NathanFSavoie/KiCad_lib/3D_Model/Assembly/mps_dcdc_oki_78sr_vert_a.step

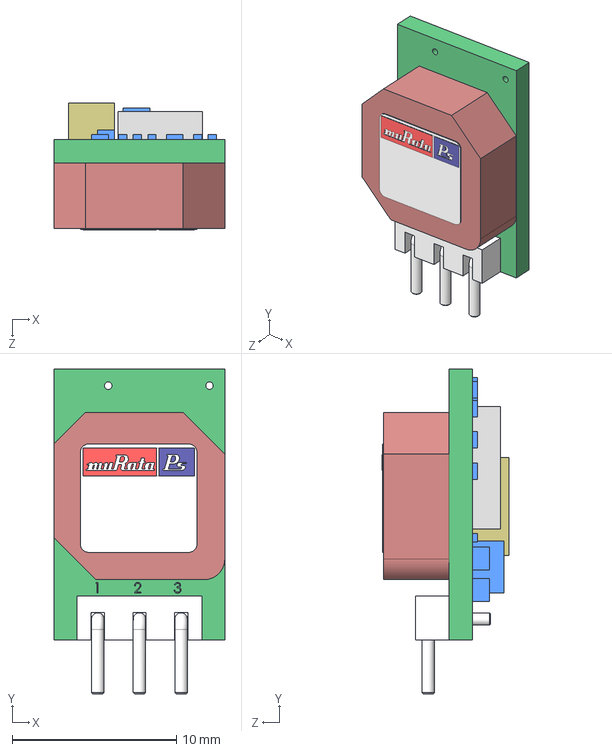
[picture p1: CAD file, 2017-04-19]
3D_Model/Assembly/mps_dcdc_oki_78sr_vert_a.step
10.4 x 19.8 x 7.73 mm
