NathanFSavoie/KiCad_lib/3D_Model/Capacitors/CAP_ALU_SMD_SIZE_D.step

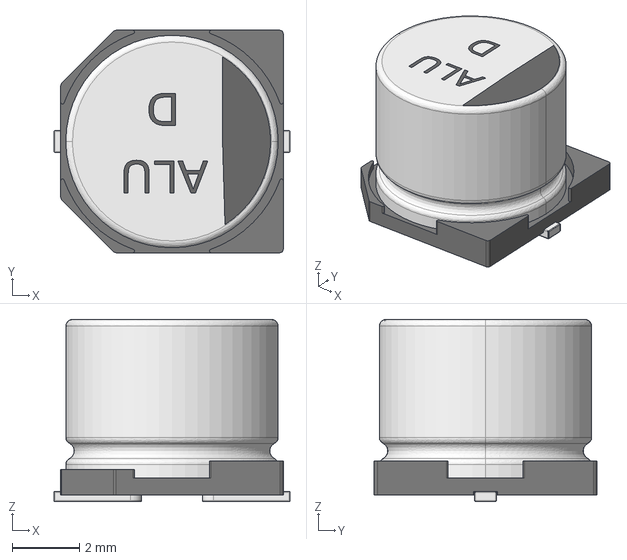
[picture p2: CAD file, 2017-10-21]
3D_Model/Capacitors/CAP_ALU_SMD_SIZE_D.step
7.00 x 6.60 x 5.40 mm
