NathanFSavoie/KiCad_lib/3D_Model/Connectors/PJ-202A.step

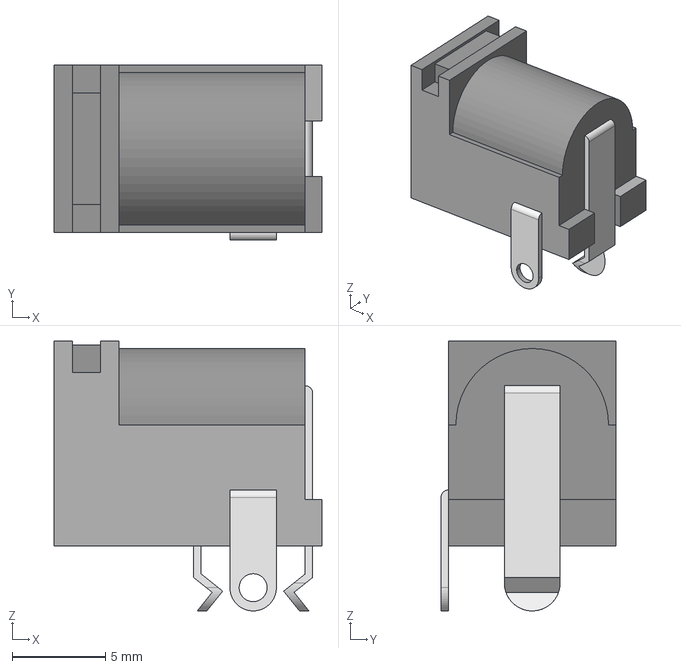
[picture p3: CAD file, 2017-10-21]
3D_Model/Connectors/PJ-202A.step
14.4 x 9.40 x 14.5 mm
