NathanFSavoie/KiCad_lib/3D_Model/Crystals/Crystal HC49_US-SM.step

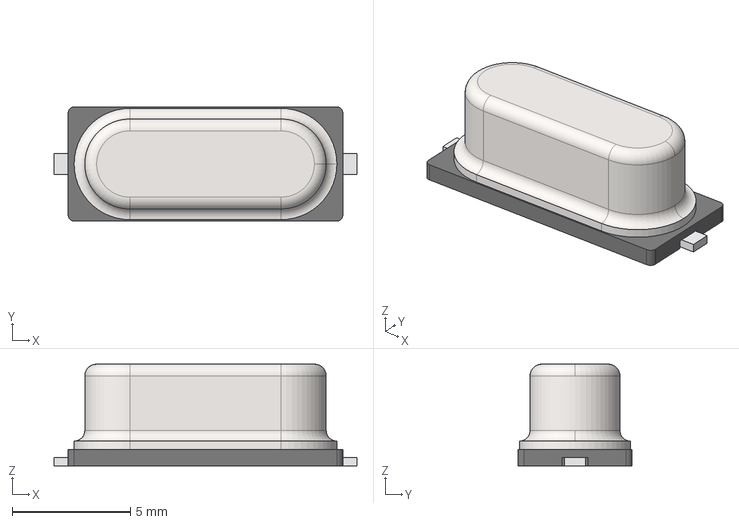
[picture p4: CAD file, 2017-10-21]
3D_Model/Crystals/Crystal HC49_US-SM.step
12.8 x 4.83 x 4.30 mm
