NathanFSavoie/KiCad_lib/3D_Model/Diodes/SOD-123.step

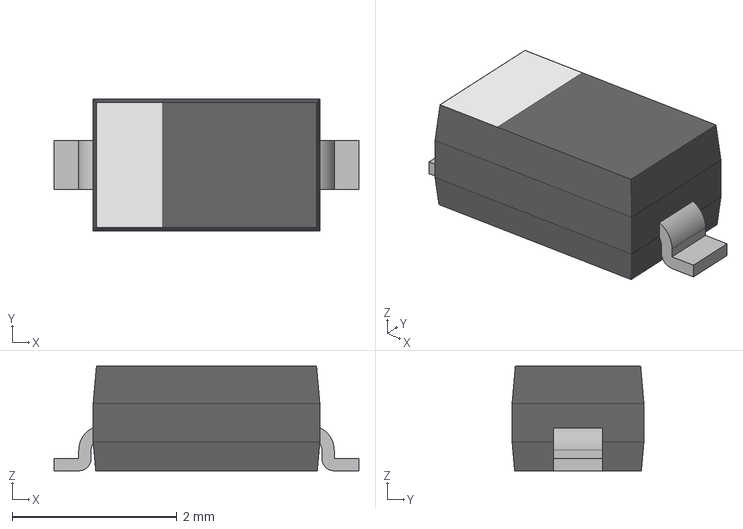
[picture p5: CAD file, 2017-11-20]
3D_Model/Diodes/SOD-123.step
3.70 x 1.60 x 1.27 mm
