NathanFSavoie/KiCad_lib/3D_Model/Fuses/F1206.step

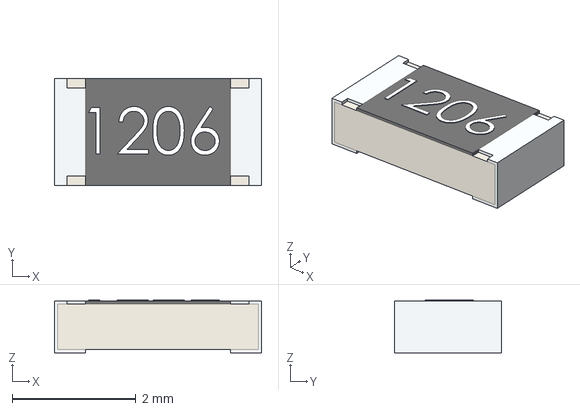
[picture p6: CAD file, 2017-10-21]
3D_Model/Fuses/F1206.step
3.35 x 1.73 x 0.85 mm
