NathanFSavoie/KiCad_lib/3D_Model/IC/SOIC-18.STEP

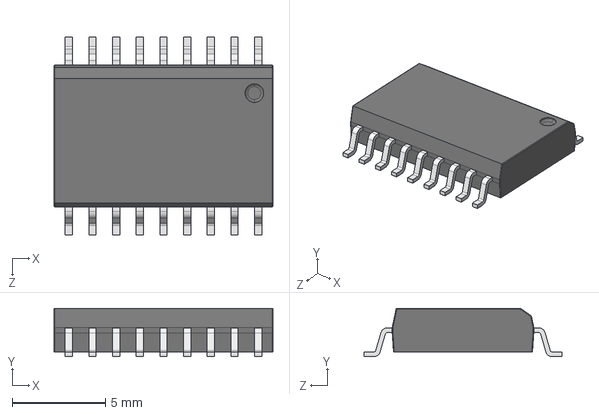
[picture p7: CAD file, 2017-10-21]
3D_Model/IC/SOIC-18.STEP
11.8 x 2.60 x 10.6 mm
User Library-SOIC-18-300_pin_SOIC_SO-300_1 x 18
User Library-SOIC-18-300_SOIC_300_SOIC_11.75X7.6_1
