NathanFSavoie/KiCad_lib/3D_Model/Inductors/LBC3225.stp

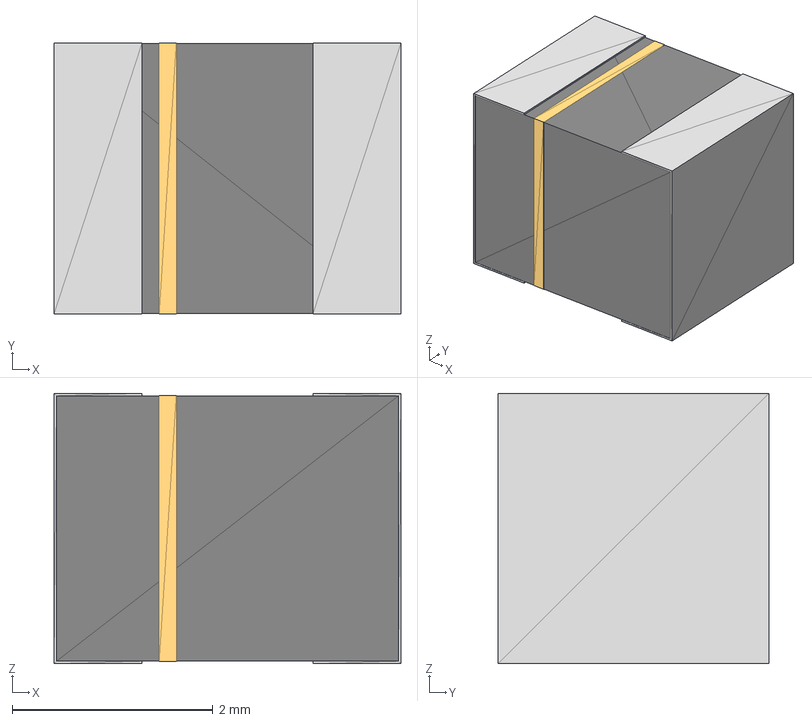
[picture p8: CAD file, 2017-05-11]
3D_Model/Inductors/LBC3225.stp
3.45 x 2.70 x 2.69 mm
