NathanFSavoie/KiCad_lib/3D_Model/Miscellaneous/MIC_CMA.step

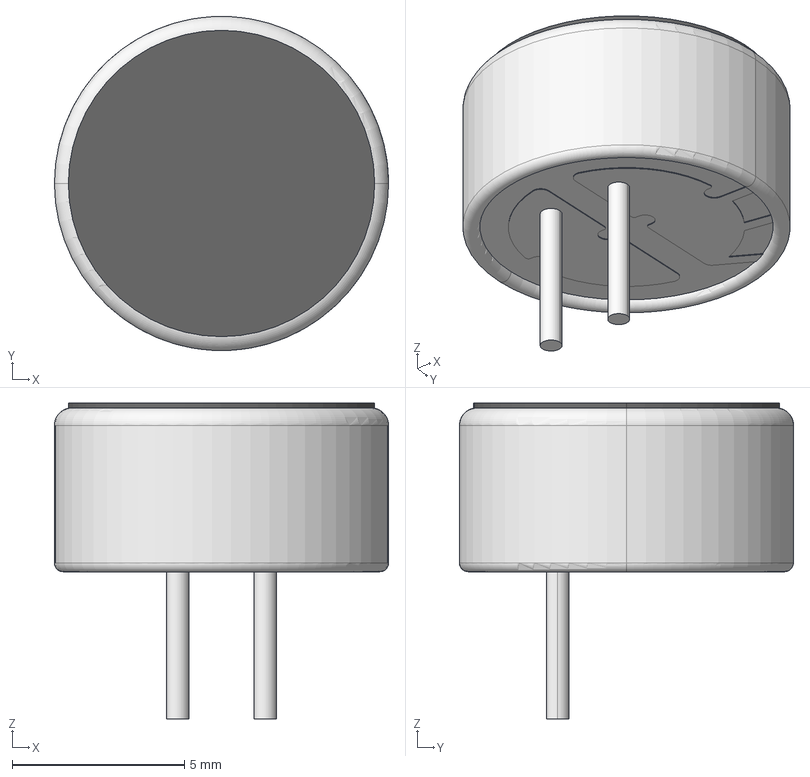
[picture p9: CAD file, 2017-10-21]
3D_Model/Miscellaneous/MIC_CMA.step
9.70 x 9.69 x 9.17 mm
