NathanFSavoie/KiCad_lib/3D_Model/Switches/Tactile_switch_6x6x5mm.step

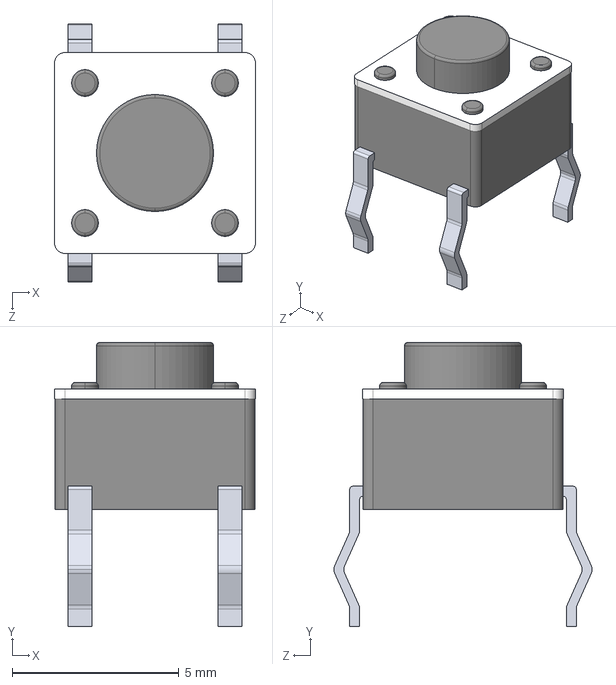
[picture p10: CAD file, 2017-01-31]
3D_Model/Switches/Tactile_switch_6x6x5mm.step
6.03 x 8.52 x 7.74 mm
