NathanFSavoie/KiCad_lib/3D_Model/Transistor/TO-220.stp

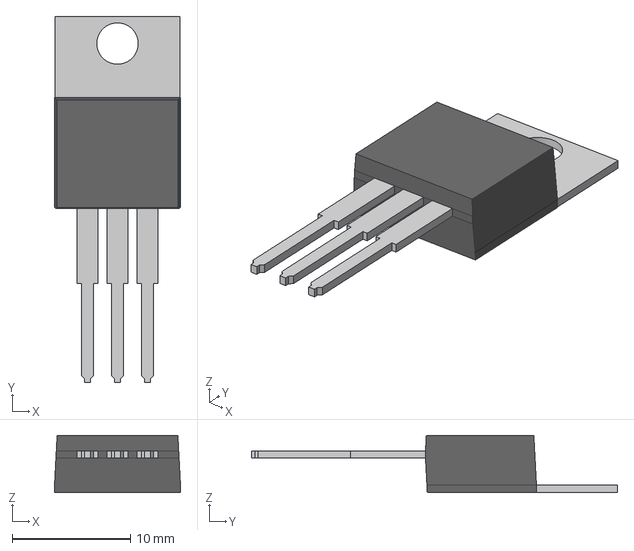
[picture p11: CAD file, 2017-10-21]
3D_Model/Transistor/TO-220.stp
10.7 x 31.0 x 4.83 mm
