NathanFSavoie/KiCad_lib/3D_Model/Assembly/mps_dcdc_oki_78sr_horiz_a.step

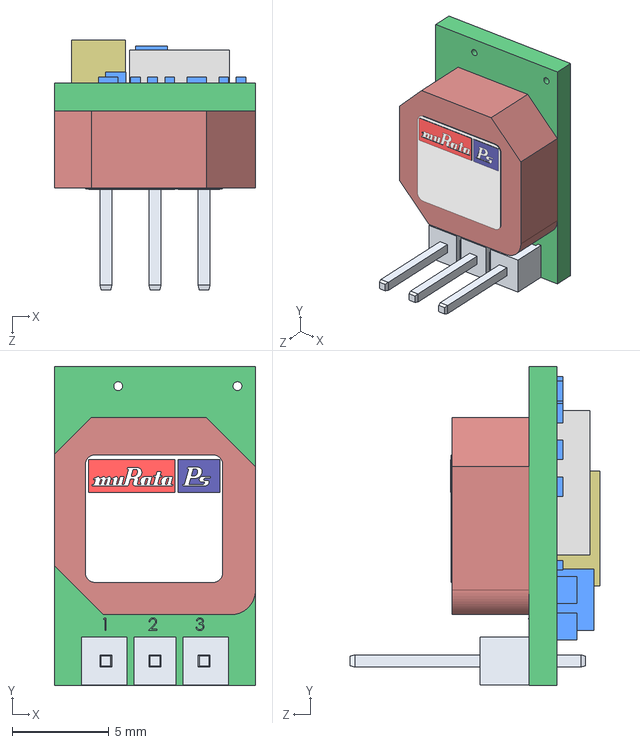
[picture p12: CAD file, 2017-04-19]
3D_Model/Assembly/mps_dcdc_oki_78sr_horiz_a.step
10.4 x 16.5 x 12.9 mm
