NathanFSavoie/KiCad_lib/3D_Model/Connectors/Male_Header_2_54mm_1X4.step

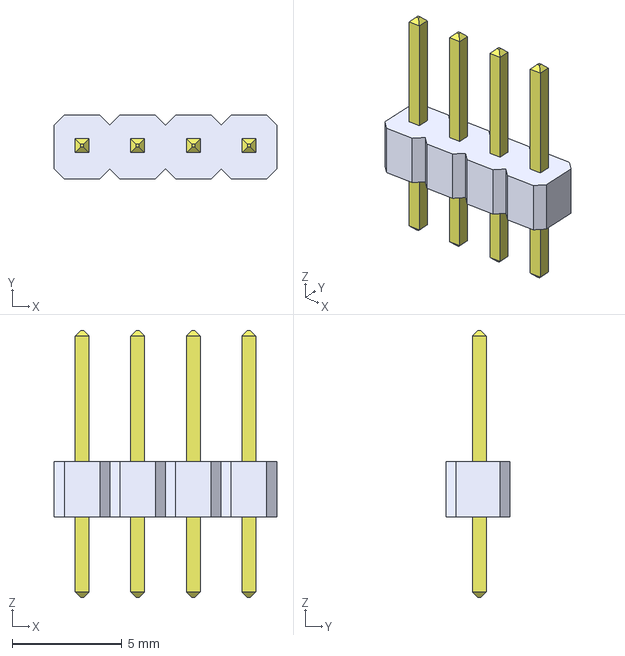
[picture p13: CAD file, 2017-10-21]
3D_Model/Connectors/Male_Header_2_54mm_1X4.step
10.2 x 2.92 x 12.2 mm
