NathanFSavoie/KiCad_lib/3D_Model/Crystals/ABS25.STEP

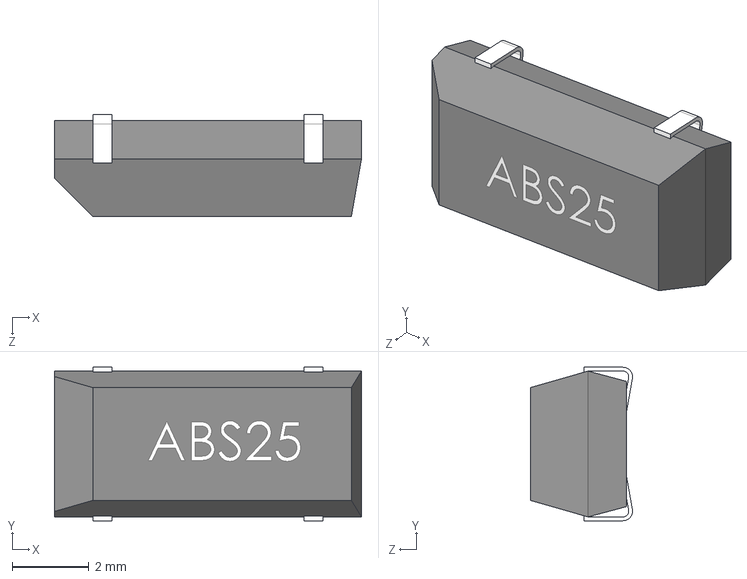
[picture p14: CAD file, 2017-04-19]
3D_Model/Crystals/ABS25.STEP
8.00 x 4.00 x 2.66 mm
