NathanFSavoie/KiCad_lib/3D_Model/Diodes/DO-201AD.step

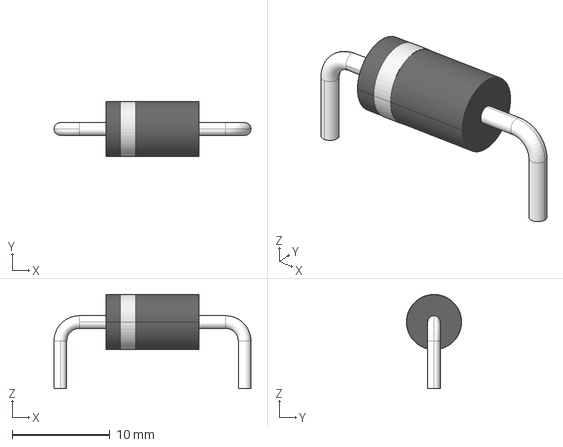
[picture p15: CAD file, 2017-10-21]
3D_Model/Diodes/DO-201AD.step
20.1 x 5.64 x 9.62 mm
