NathanFSavoie/KiCad_lib/3D_Model/Fuses/Littelfuse_562.stp

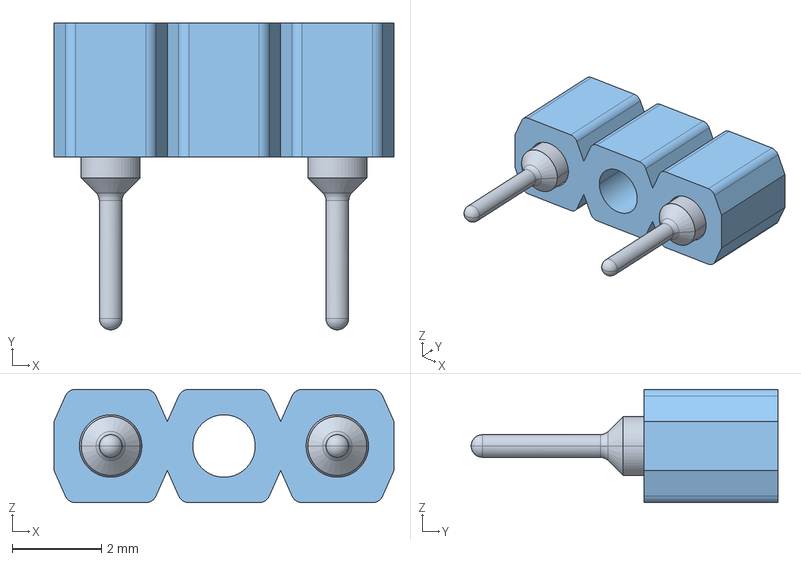
[picture p16: CAD file, 2017-04-29]
3D_Model/Fuses/Littelfuse_562.stp
7.62 x 6.88 x 2.54 mm
