NathanFSavoie/KiCad_lib/3D_Model/IC/SIP_4__Pitch_2_54mm.step

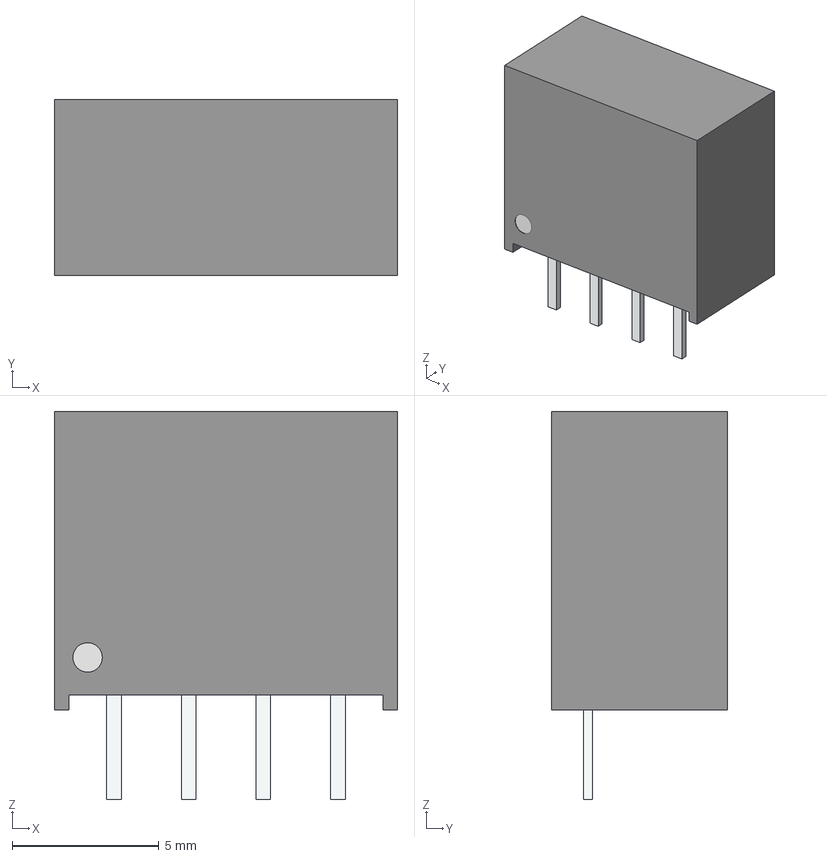
[picture p17: CAD file, 2017-10-21]
3D_Model/IC/SIP_4__Pitch_2_54mm.step
11.7 x 6.00 x 13.2 mm
