NathanFSavoie/KiCad_lib/3D_Model/Inductors/RLB0608.step

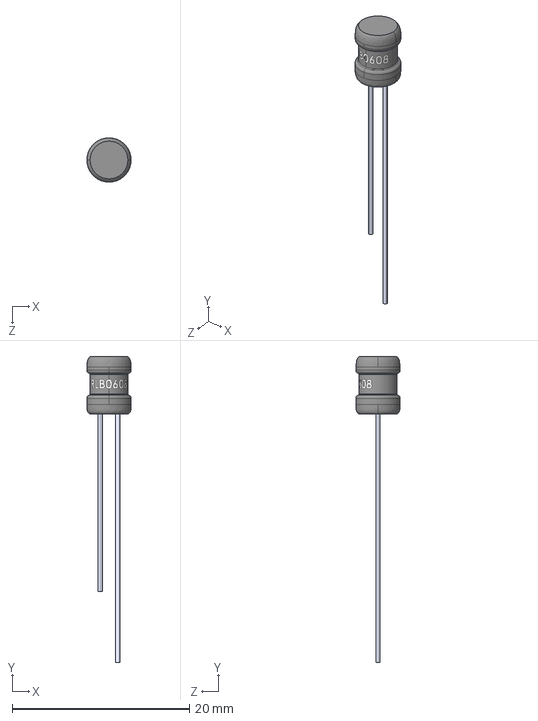
[picture p18: CAD file, 2017-05-09]
3D_Model/Inductors/RLB0608.step
5.00 x 34.5 x 5.00 mm
