NathanFSavoie/KiCad_lib/3D_Model/Resistors/Bourns 3362R_sp.step

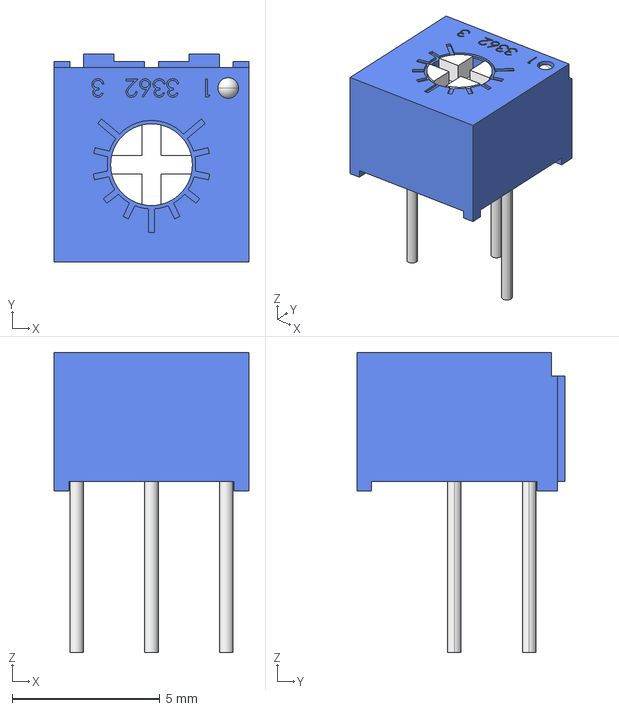
[picture p19: CAD file, 2017-10-21]
3D_Model/Resistors/Bourns 3362R_sp.step
6.60 x 7.05 x 10.2 mm
