NathanFSavoie/KiCad_lib/3D_Model/Capacitors/CAP_ALU_SMD_SIZE_B.step

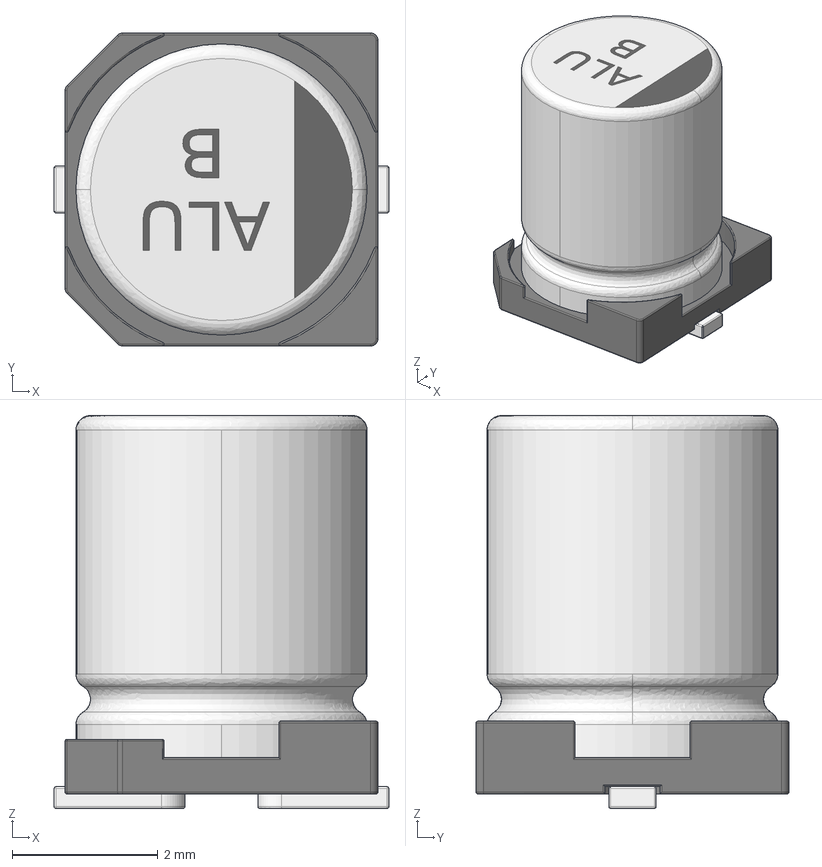
[picture p21: CAD file, 2017-10-21]
3D_Model/Capacitors/CAP_ALU_SMD_SIZE_B.step
4.60 x 4.30 x 5.40 mm
