NathanFSavoie/KiCad_lib/3D_Model/Connectors/Headers_2.54mm_1X9.step

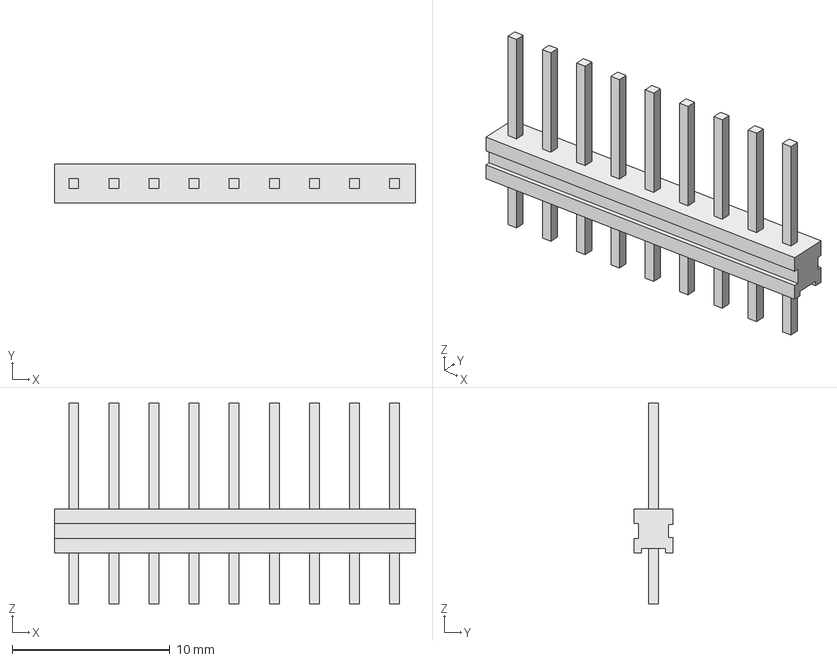
[picture p22: CAD file, 2017-10-21]
3D_Model/Connectors/Headers_2.54mm_1X9.step
22.9 x 2.50 x 12.7 mm
