NathanFSavoie/KiCad_lib/3D_Model/Diodes/LED 1206_GREEN.step

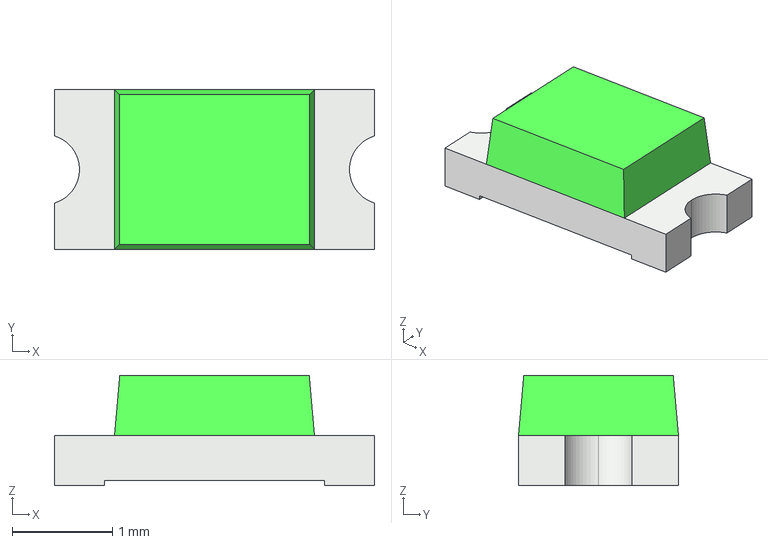
[picture p23: CAD file, 2017-10-21]
3D_Model/Diodes/LED 1206_GREEN.step
3.20 x 1.60 x 1.10 mm
