NathanFSavoie/KiCad_lib/3D_Model/Fuses/Littelfuse_TE5_395.step

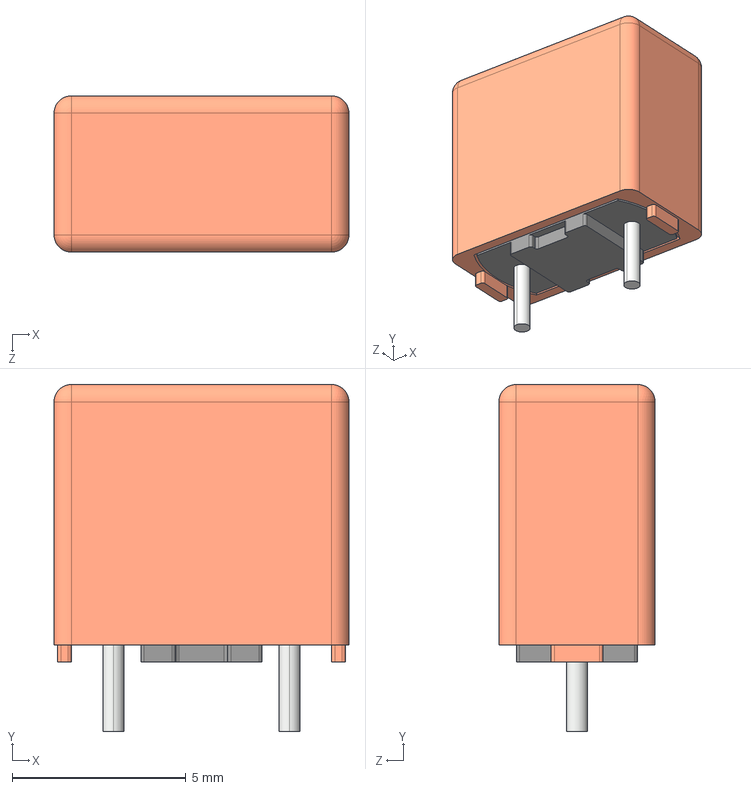
[picture p24: CAD file, 2017-04-29]
3D_Model/Fuses/Littelfuse_TE5_395.step
8.50 x 10.0 x 4.50 mm
