NathanFSavoie/KiCad_lib/3D_Model/IC/SOIC-8.step

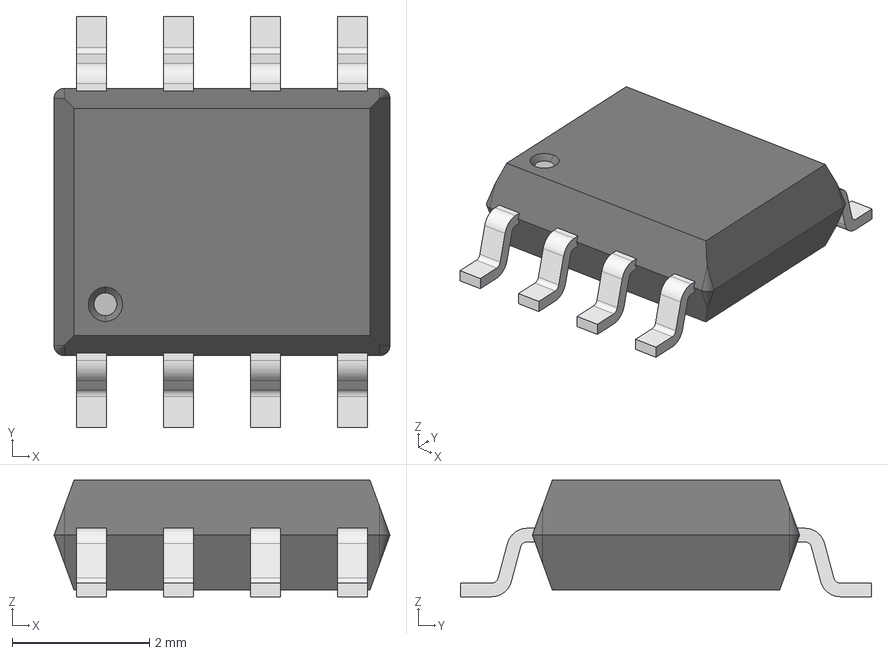
[picture p25: CAD file, 2017-10-21]
3D_Model/IC/SOIC-8.step
4.90 x 6.00 x 1.70 mm
