NathanFSavoie/KiCad_lib/3D_Model/Inductors/I1206.step

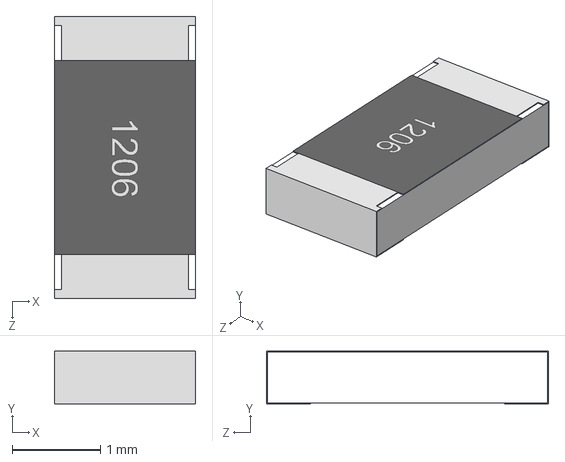
[picture p26: CAD file, 2017-04-19]
3D_Model/Inductors/I1206.step
1.60 x 0.6 x 3.20 mm
