NathanFSavoie/KiCad_lib/3D_Model/Resistors/P160KN2.step

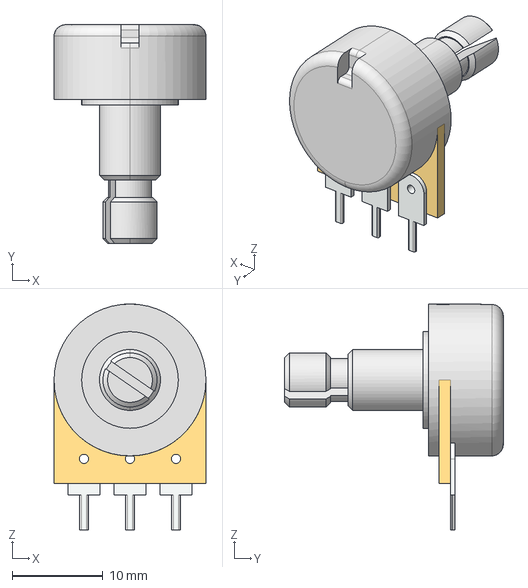
[picture p27: CAD file, 2017-10-21]
3D_Model/Resistors/P160KN2.step
16.8 x 24.1 x 24.9 mm
