NathanFSavoie/KiCad_lib/3D_Model/Capacitors/CAP_ALU_SMD_SIZE_C.step

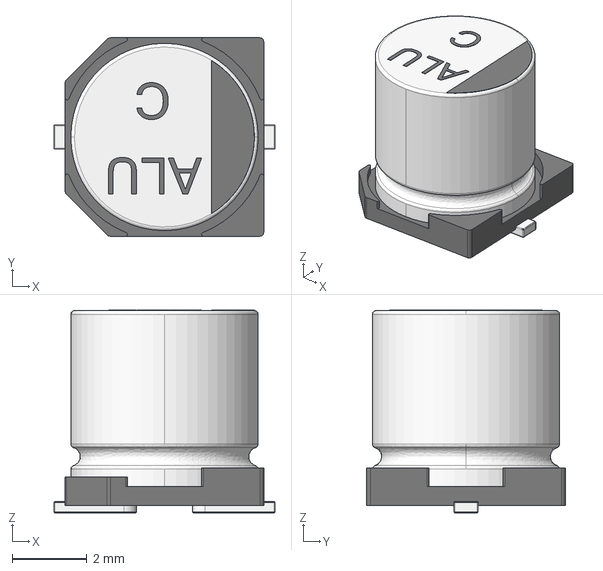
[picture p28: CAD file, 2017-10-21]
3D_Model/Capacitors/CAP_ALU_SMD_SIZE_C.step
5.90 x 5.30 x 5.41 mm
