NathanFSavoie/KiCad_lib/3D_Model/Diodes/SOD-323.step

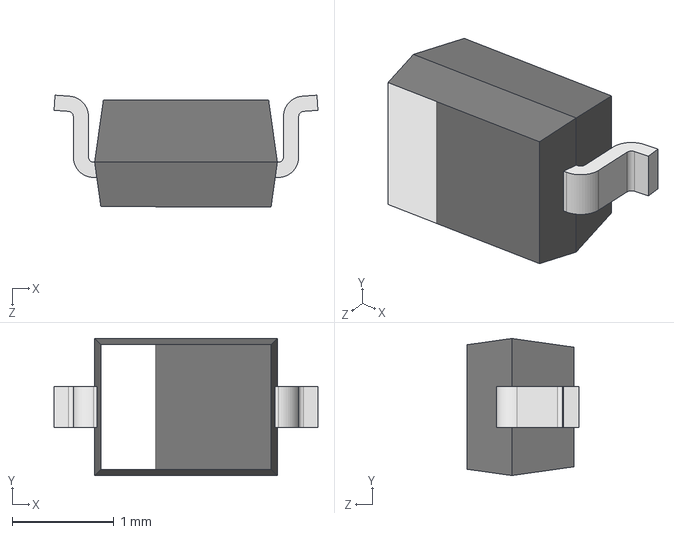
[picture p29: CAD file, 2017-05-11]
3D_Model/Diodes/SOD-323.step
2.60 x 1.35 x 1.10 mm
