NathanFSavoie/KiCad_lib/3D_Model/IC/LQFP-32.step

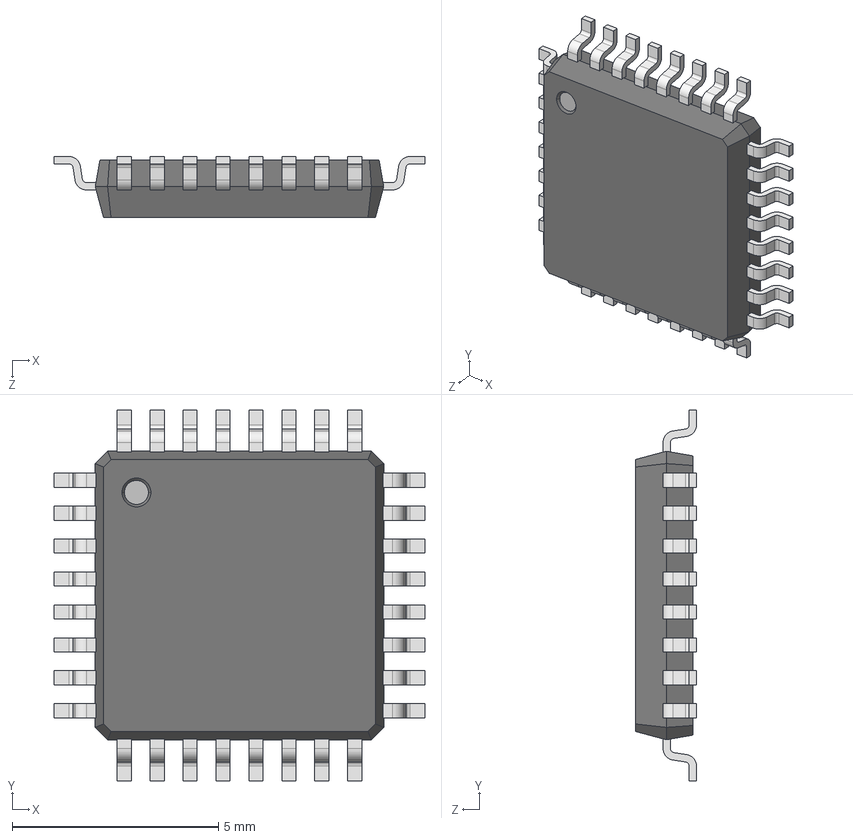
[picture p30: CAD file, 2017-05-03]
3D_Model/IC/LQFP-32.step
9.00 x 9.00 x 1.48 mm
