NathanFSavoie/KiCad_lib/3D_Model/Inductors/SRR4018.stp

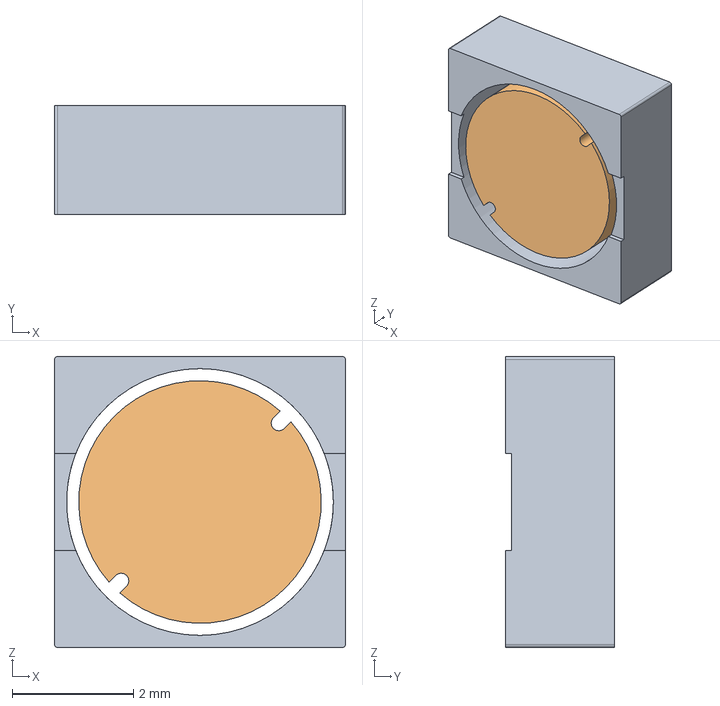
[picture p31: CAD file, 2017-01-22]
3D_Model/Inductors/SRR4018.stp
4.80 x 1.80 x 4.80 mm
