NathanFSavoie/KiCad_lib/3D_Model/Resistors/CT-6EP.stp

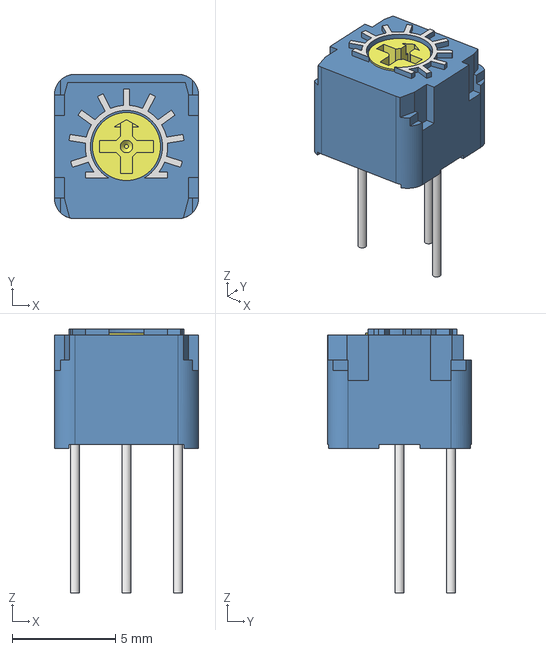
[picture p32: CAD file, 2017-05-03]
3D_Model/Resistors/CT-6EP.stp
7.00 x 7.00 x 12.8 mm
_CT-6EP-1
_CT-6-dial
