NathanFSavoie/KiCad_lib/3D_Model/Capacitors/UVZ_6_3×11.stp

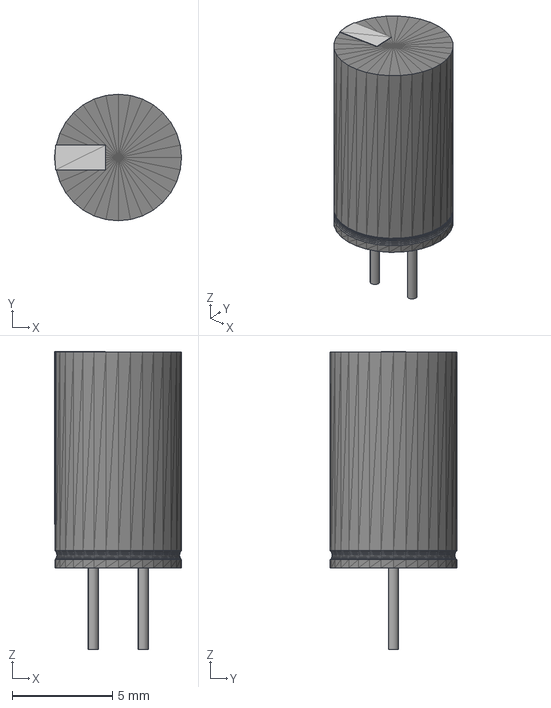
[picture p33: CAD file, 2017-05-10]
3D_Model/Capacitors/UVZ_6_3×11.stp
6.32 x 6.30 x 14.8 mm
