NathanFSavoie/KiCad_lib/3D_Model/Connectors/CTDEFAU05151246231556_sp.step

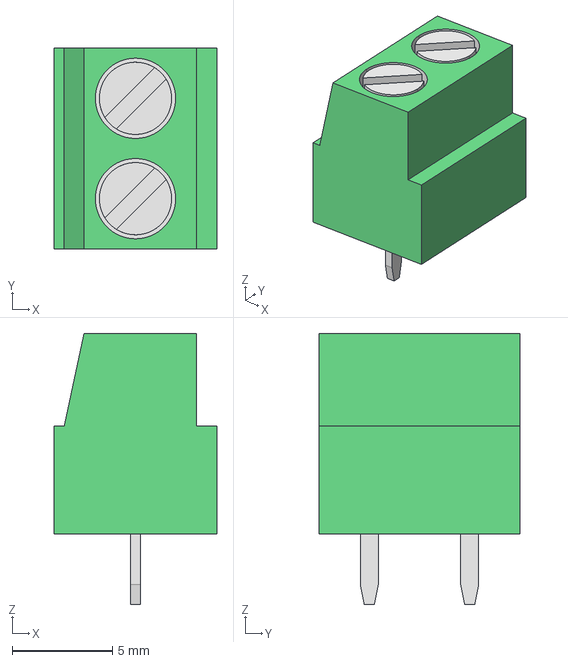
[picture p34: CAD file, 2017-10-21]
3D_Model/Connectors/CTDEFAU05151246231556_sp.step
8.10 x 10.0 x 13.5 mm
