NathanFSavoie/KiCad_lib/3D_Model/Diodes/WL-SMCW-0805.stp

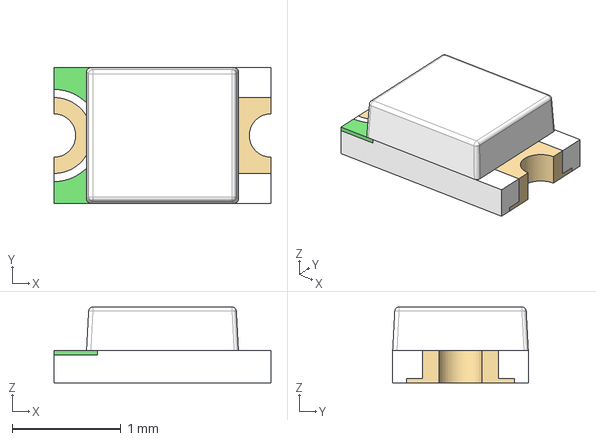
[picture p35: CAD file, 2017-04-29]
3D_Model/Diodes/WL-SMCW-0805.stp
2.00 x 1.25 x 0.7 mm
