NathanFSavoie/KiCad_lib/3D_Model/IC/SOT-363.step

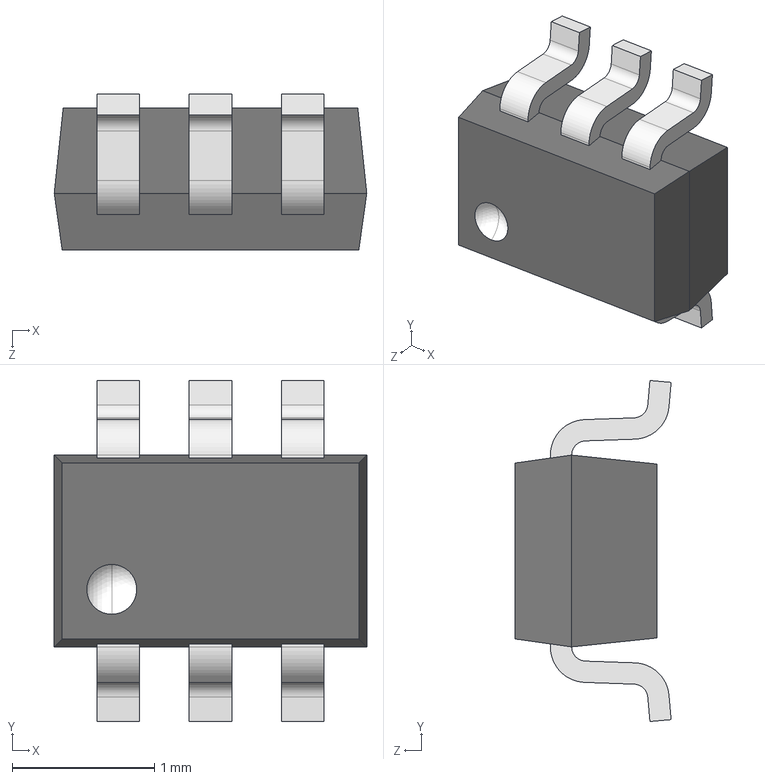
[picture p36: CAD file, 2017-04-30]
3D_Model/IC/SOT-363.step
2.20 x 2.40 x 1.10 mm
