NathanFSavoie/KiCad_lib/3D_Model/Inductors/SRR4028.stp

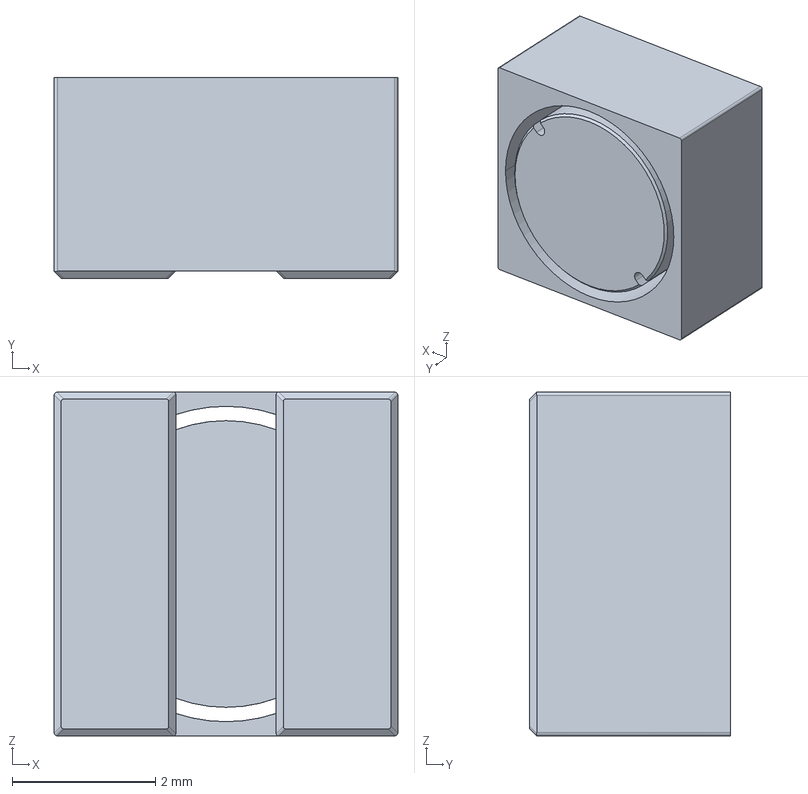
[picture p37: CAD file, 2017-01-22]
3D_Model/Inductors/SRR4028.stp
4.80 x 2.80 x 4.80 mm
