NathanFSavoie/KiCad_lib/3D_Model/Resistors/R0603.step

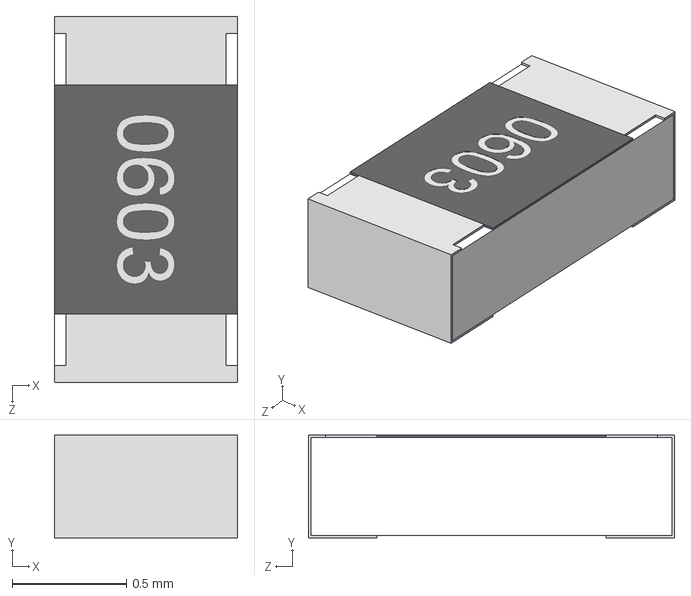
[picture p38: CAD file, 2017-04-19]
3D_Model/Resistors/R0603.step
0.8 x 0.45 x 1.60 mm
