NathanFSavoie/KiCad_lib/3D_Model/Capacitors/C1210.step

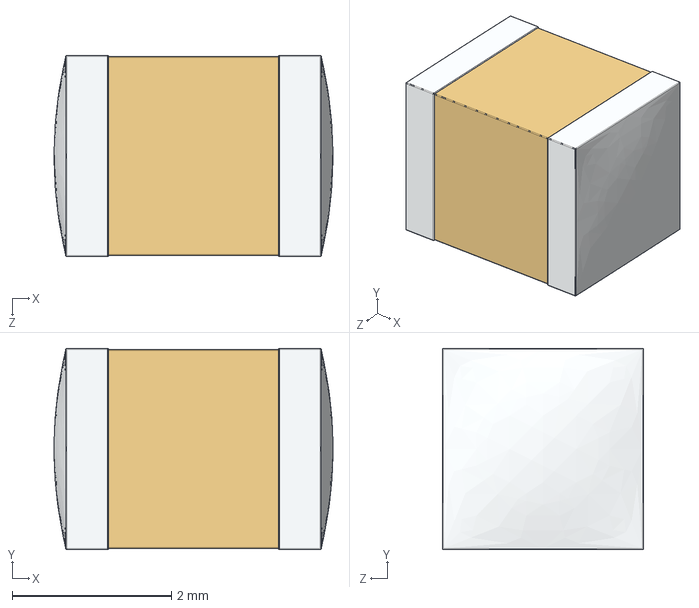
[picture p39: CAD file, 2017-01-18]
3D_Model/Capacitors/C1210.step
3.50 x 2.52 x 2.53 mm
