NathanFSavoie/KiCad_lib/3D_Model/Diodes/4-sip_KBU.step

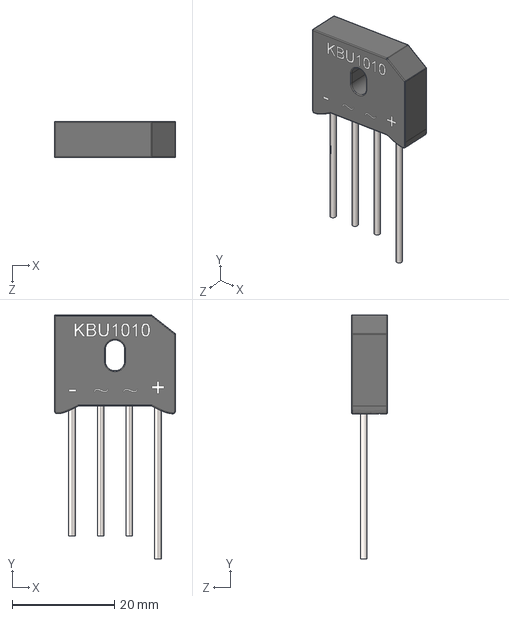
[picture p40: CAD file, 2017-01-22]
3D_Model/Diodes/4-sip_KBU.step
23.7 x 47.7 x 7.10 mm
