NathanFSavoie/KiCad_lib/3D_Model/IC/LQFP-64.step

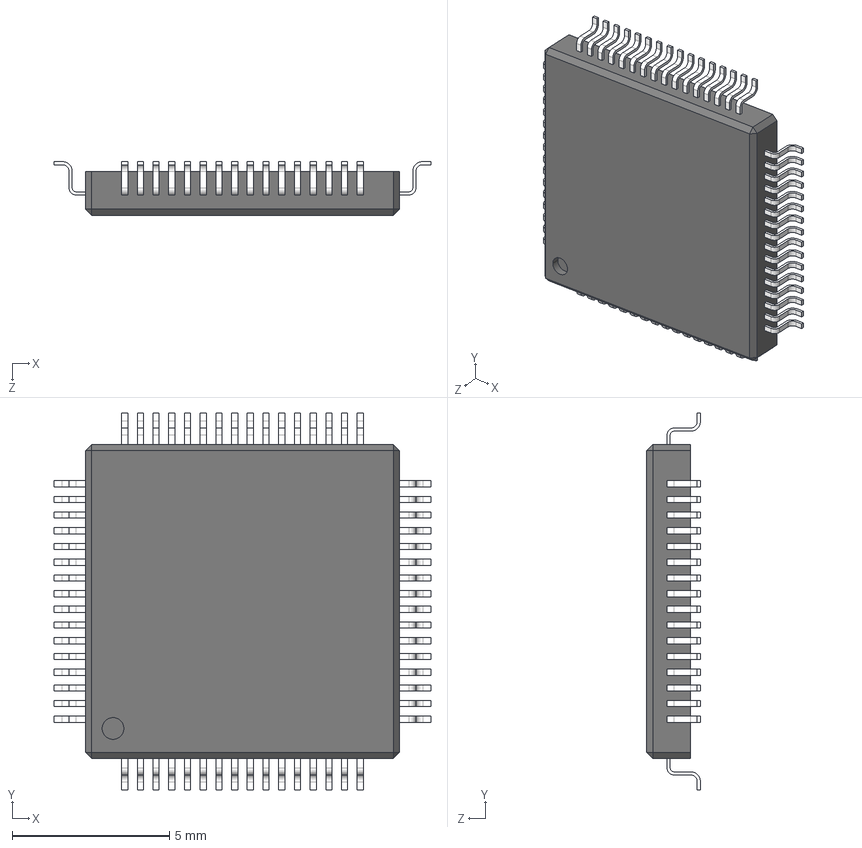
[picture p41: CAD file, 2017-04-19]
3D_Model/IC/LQFP-64.step
12.0 x 12.0 x 1.71 mm
