NathanFSavoie/KiCad_lib/3D_Model/Inductors/SRR1208.step

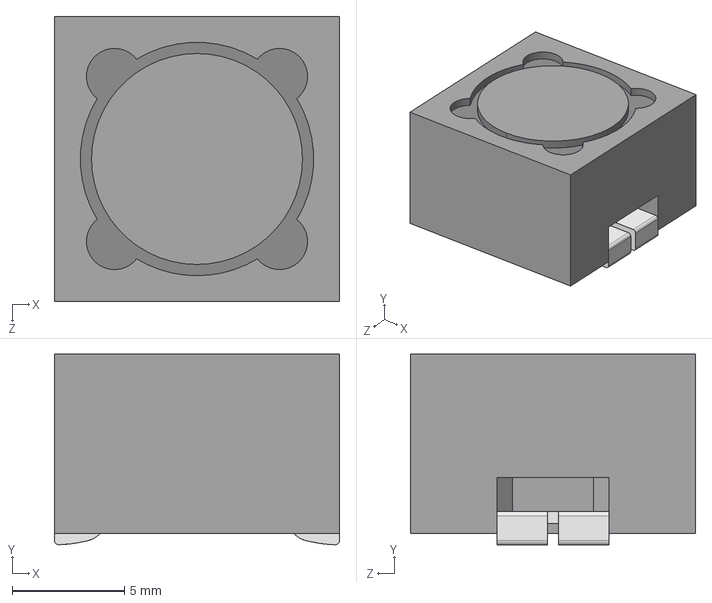
[picture p42: CAD file, 2017-01-22]
3D_Model/Inductors/SRR1208.step
12.7 x 8.49 x 12.7 mm
