NathanFSavoie/KiCad_lib/3D_Model/Resistors/R2010.step

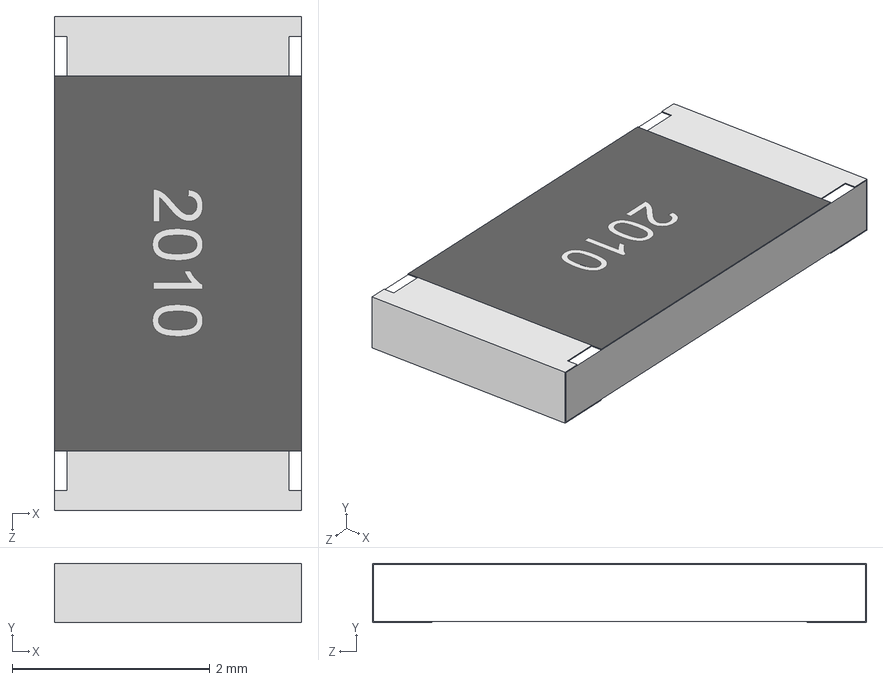
[picture p43: CAD file, 2017-04-19]
3D_Model/Resistors/R2010.step
2.50 x 0.6 x 5.00 mm
