NathanFSavoie/KiCad_lib/3D_Model/Capacitors/C0805.step

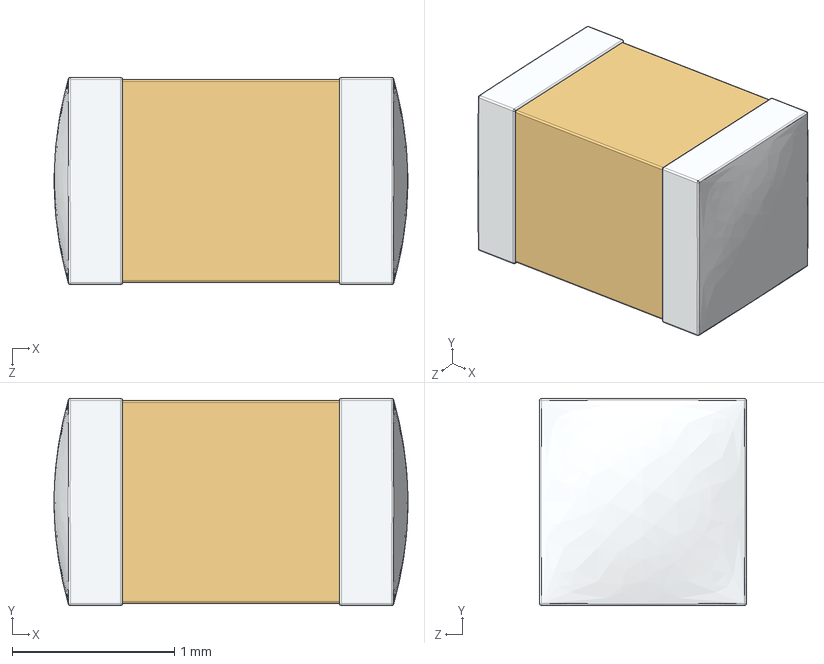
[picture p44: CAD file, 2017-01-18]
3D_Model/Capacitors/C0805.step
2.18 x 1.27 x 1.27 mm
