NathanFSavoie/KiCad_lib/3D_Model/Diodes/ll-34.step

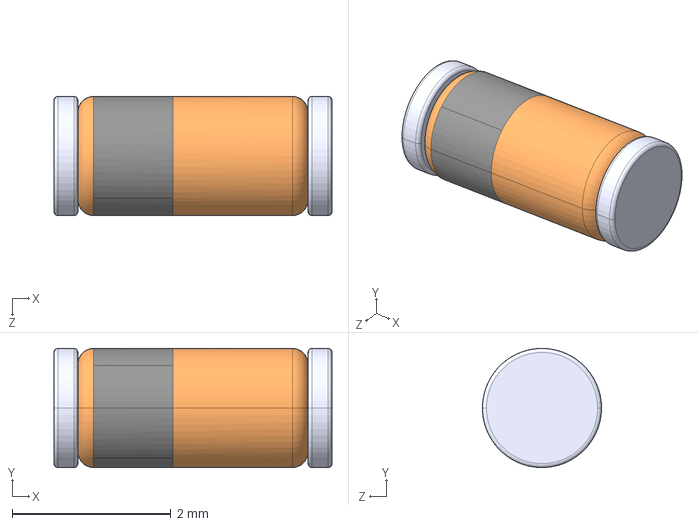
[picture p45: CAD file, 2017-01-22]
3D_Model/Diodes/ll-34.step
3.50 x 1.50 x 1.50 mm
