NathanFSavoie/KiCad_lib/3D_Model/IC/TO-220-Coucher.step

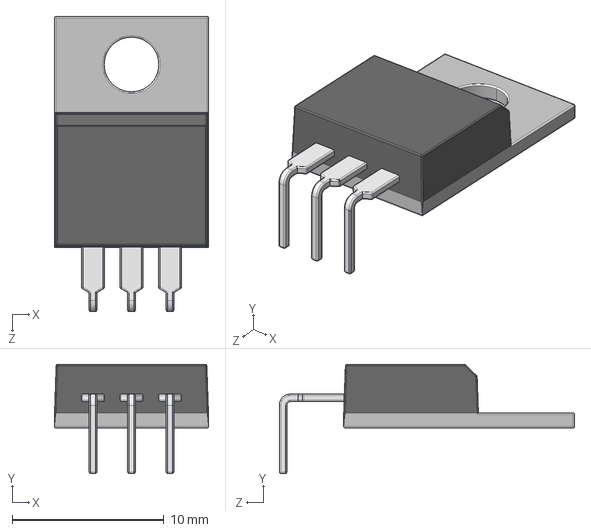
[picture p46: CAD file, 2017-01-18]
3D_Model/IC/TO-220-Coucher.step
10.2 x 7.20 x 19.5 mm
