NathanFSavoie/KiCad_lib/3D_Model/Resistors/R2512.step

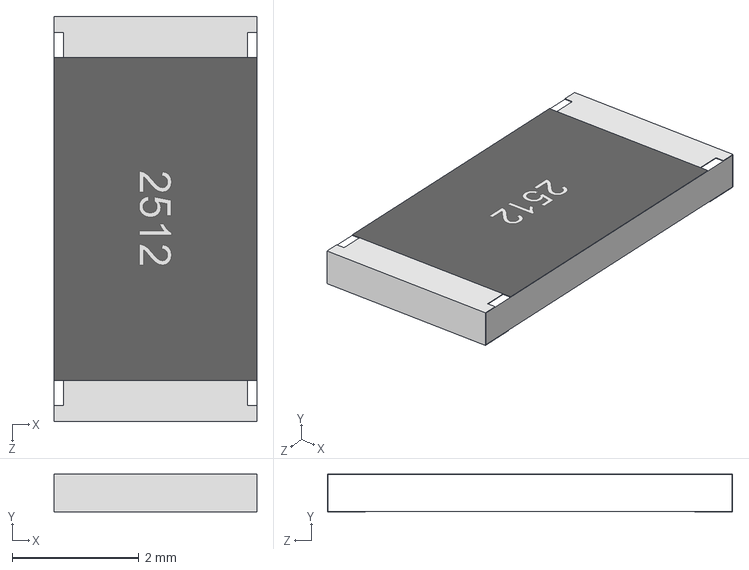
[picture p47: CAD file, 2017-04-19]
3D_Model/Resistors/R2512.step
3.20 x 0.6 x 6.40 mm
