NathanFSavoie/KiCad_lib/3D_Model/Diodes/SOD-923.step

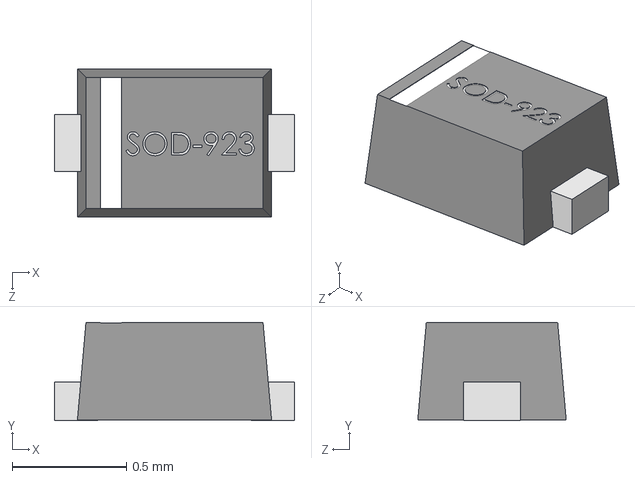
[picture p48: CAD file, 2017-01-22]
3D_Model/Diodes/SOD-923.step
1.05 x 0.43 x 0.65 mm
