NathanFSavoie/KiCad_lib/3D_Model/IC/SOIC-24-300.STEP

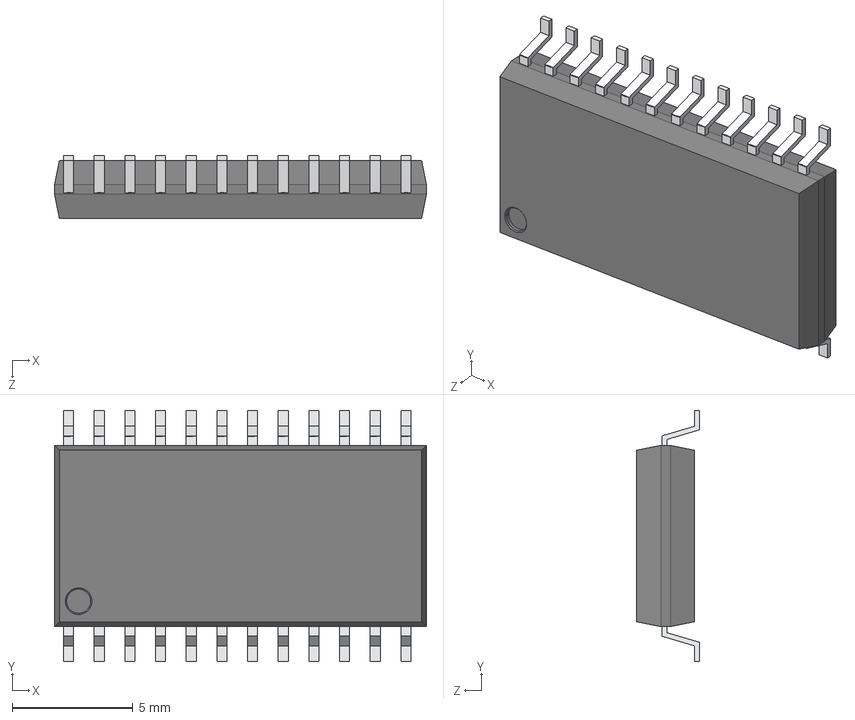
[picture p49: CAD file, 2017-01-18]
3D_Model/IC/SOIC-24-300.STEP
15.4 x 10.4 x 2.60 mm
User Library-SOIC_24-300_pino1
User Library-SOIC_24-300_pino002
User Library-SOIC_24-300_pino003
User Library-SOIC_24-300_pino004
User Library-SOIC_24-300_pino005
User Library-SOIC_24-300_pino006
User Library-SOIC_24-300_pino007
User Library-SOIC_24-300_pino008
User Library-SOIC_24-300_pino009
User Library-SOIC_24-300_pino010
User Library-SOIC_24-300_pino011
User Library-SOIC_24-300_pino012
User Library-SOIC_24-300_pino013
User Library-SOIC_24-300_pino014
User Library-SOIC_24-300_pino015
User Library-SOIC_24-300_pino016
User Library-SOIC_24-300_pino017
User Library-SOIC_24-300_pino018
User Library-SOIC_24-300_pino019
User Library-SOIC_24-300_pino020
User Library-SOIC_24-300_pino021
User Library-SOIC_24-300_pino022
User Library-SOIC_24-300_pino023
User Library-SOIC_24-300_pino024
User Library-SOIC_24-300_body_finished
