NathanFSavoie/KiCad_lib/3D_Model/Resistors/R1218.step

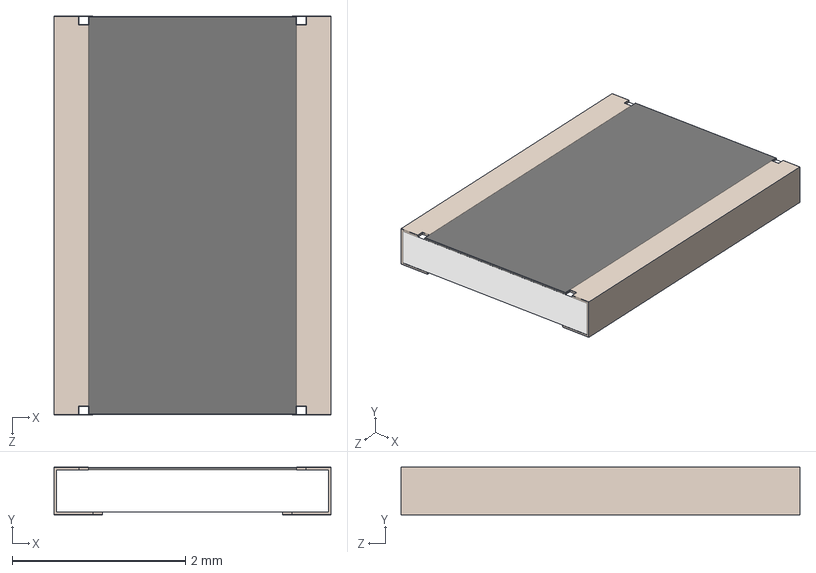
[picture p50: CAD file, 2017-04-19]
3D_Model/Resistors/R1218.step
3.20 x 0.55 x 4.61 mm
