NathanFSavoie/KiCad_lib/3D_Model/Diodes/SOD-123FL.step

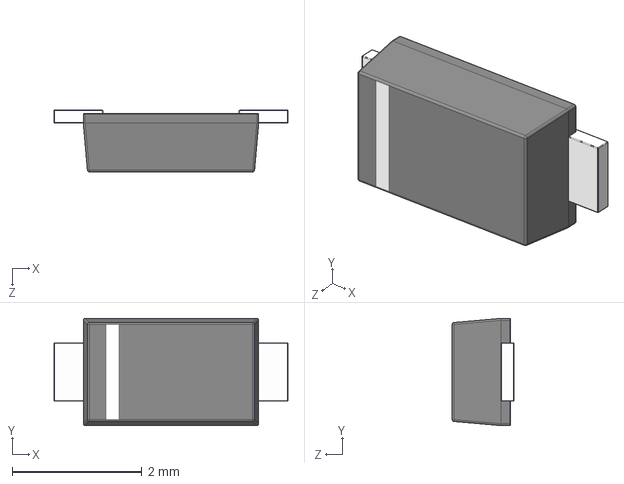
[picture p51: CAD file, 2017-01-22]
3D_Model/Diodes/SOD-123FL.step
3.60 x 1.65 x 0.951 mm
