NathanFSavoie/KiCad_lib/3D_Model/IC/SOIC-16.step

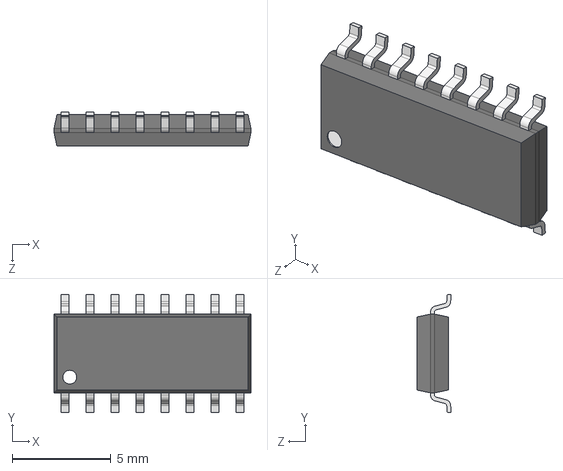
[picture p52: CAD file, 2017-01-18]
3D_Model/IC/SOIC-16.step
10.0 x 6.00 x 1.75 mm
