NathanFSavoie/KiCad_lib/3D_Model/Resistors/R1812.step

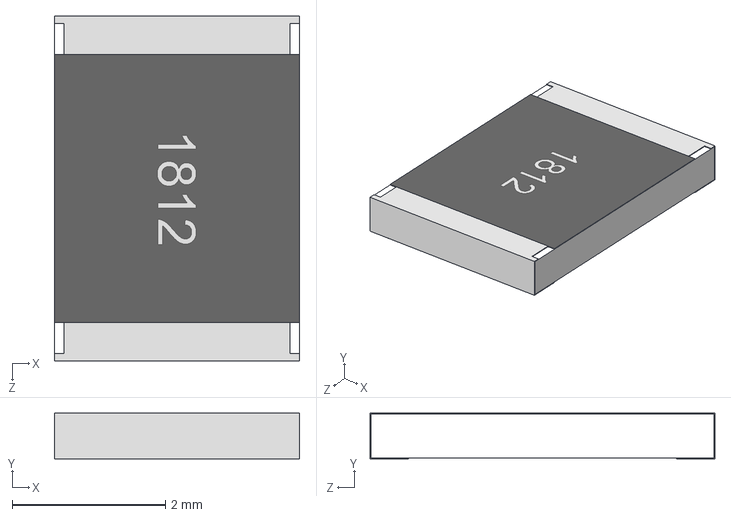
[picture p53: CAD file, 2017-04-19]
3D_Model/Resistors/R1812.step
3.20 x 0.6 x 4.50 mm
