NathanFSavoie/KiCad_lib/3D_Model/Connectors/Editable-Header_Male_40Pin.STEP

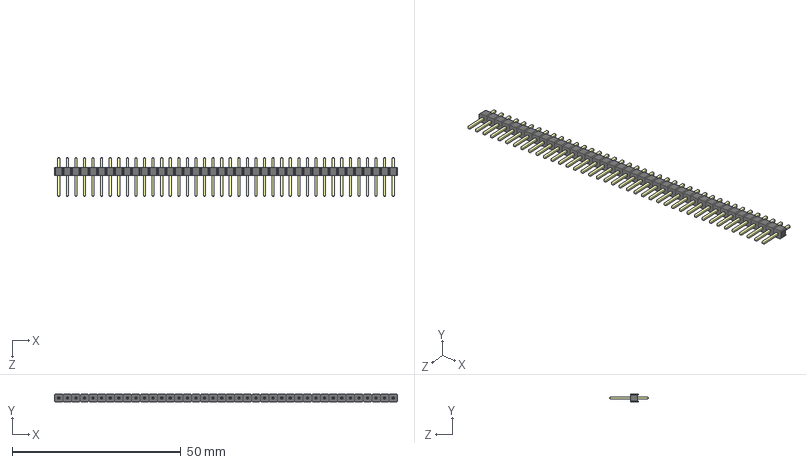
[picture p54: CAD file, 2017-04-19]
3D_Model/Connectors/Editable-Header_Male_40Pin.STEP
101.6 x 2.49 x 11.5 mm
User Library-Header_Male_40Pin_BodyArray
User Library-Header_Male_40Pin_PinArray
