NathanFSavoie/KiCad_lib/3D_Model/Diodes/R-6.step

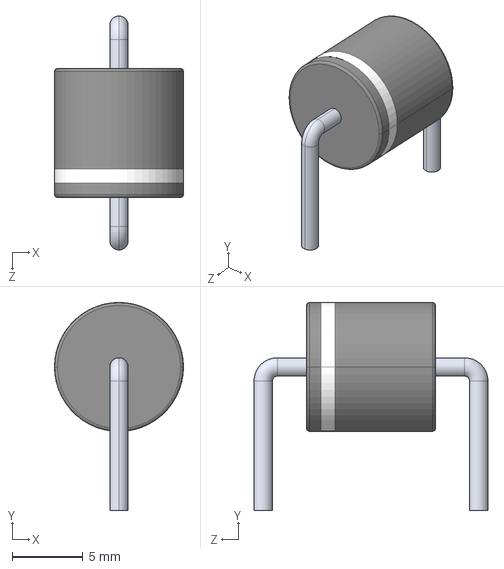
[picture p55: CAD file, 2017-01-22]
3D_Model/Diodes/R-6.step
9.12 x 14.7 x 16.5 mm
