NathanFSavoie/KiCad_lib/3D_Model/IC/TO-220-5.step

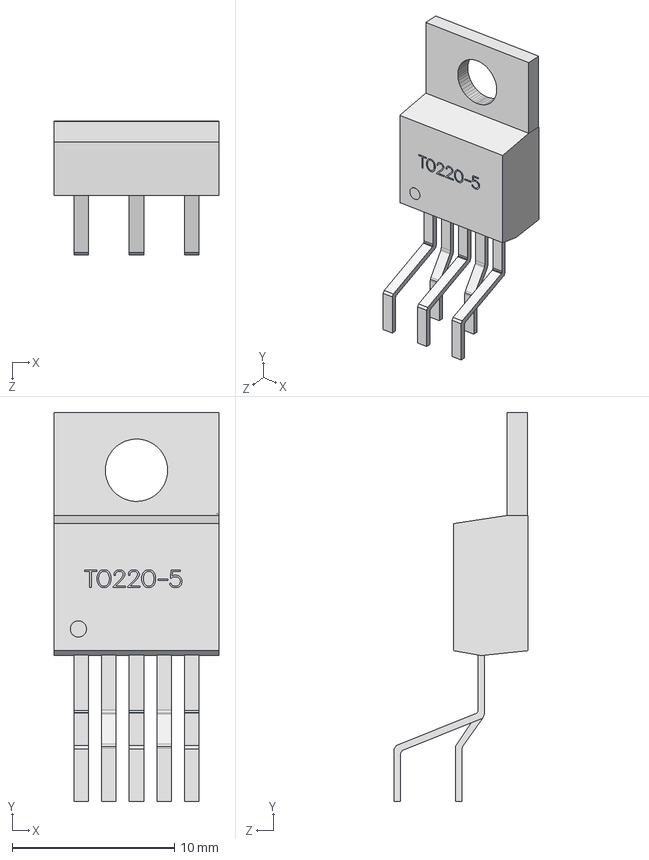
[picture p56: CAD file, 2017-01-18]
3D_Model/IC/TO-220-5.step
10.2 x 24.0 x 8.24 mm
SW3dPS-TO220-5_Board4
SW3dPS-TO220-5_Extruded13
SW3dPS-TO220-5_Extruded11
SW3dPS-TO220-5_Board3
SW3dPS-TO220-5_Cylinder1
SW3dPS-TO220-5_Extruded18 x 2
SW3dPS-TO220-5_Extruded16 x 2
SW3dPS-TO220-5_Extruded15 x 2
SW3dPS-TO220-5_Extruded10 x 2
SW3dPS-TO220-5_Extruded19
SW3dPS-TO220-5_Extruded12
SW3dPS-TO220-5_Board5
SW3dPS-TO220-5_Extruded17
SW3dPS-TO220-5_Extruded14
