NathanFSavoie/KiCad_lib/3D_Model/Resistors/R1210.step

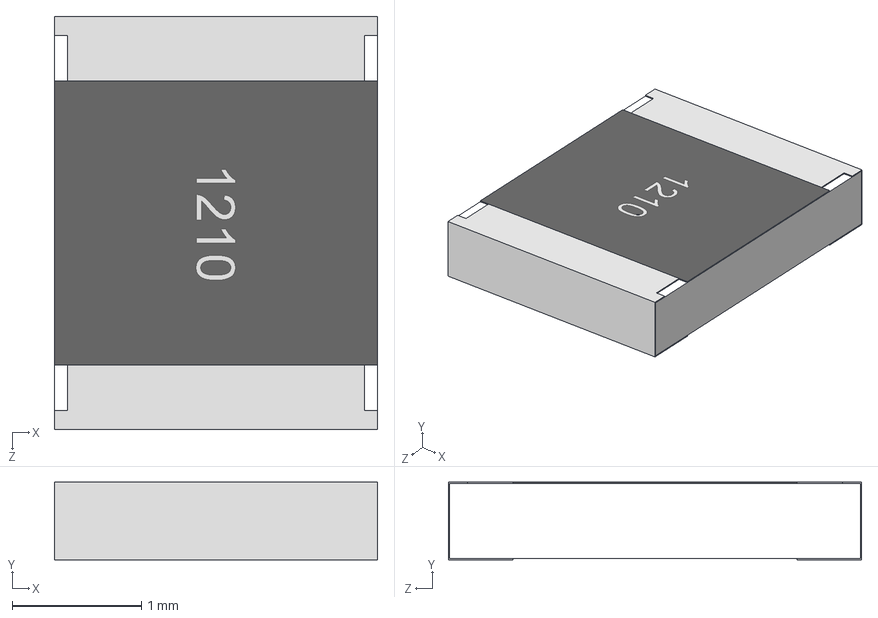
[picture p57: CAD file, 2017-04-19]
3D_Model/Resistors/R1210.step
2.50 x 0.6 x 3.20 mm
