NathanFSavoie/KiCad_lib/3D_Model/Connectors/Test_Point_Keystone_5001_BLACK.STEP

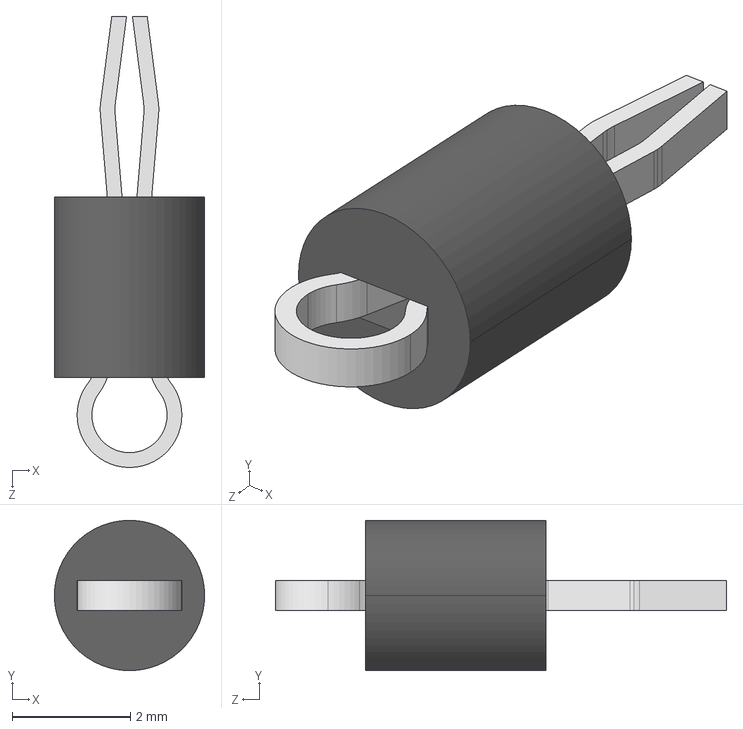
[picture p58: CAD file, 2017-04-19]
3D_Model/Connectors/Test_Point_Keystone_5001_BLACK.STEP
2.54 x 2.54 x 7.62 mm
User Library-Test Point Keystone - 5001 BLACK_1
User Library-Test Point Keystone - 5001 BLACK_2
