NathanFSavoie/KiCad_lib/3D_Model/Diodes/DO-214AA_SMB.step

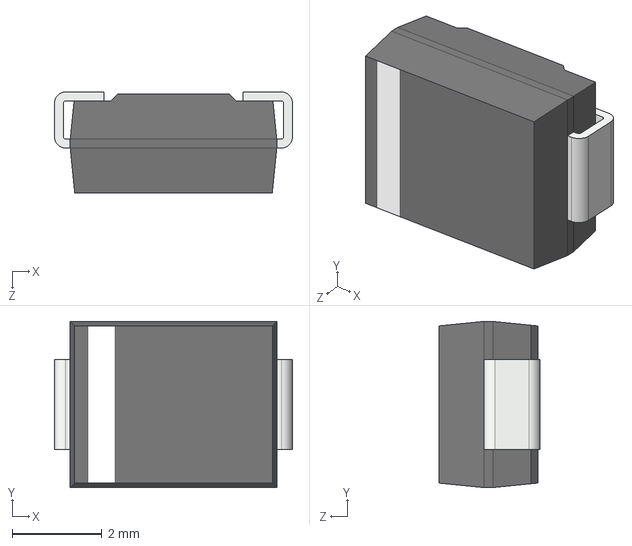
[picture p59: CAD file, 2017-01-22]
3D_Model/Diodes/DO-214AA_SMB.step
5.30 x 3.70 x 2.25 mm
