NathanFSavoie/KiCad_lib/3D_Model/IC/SOT-23-5.step

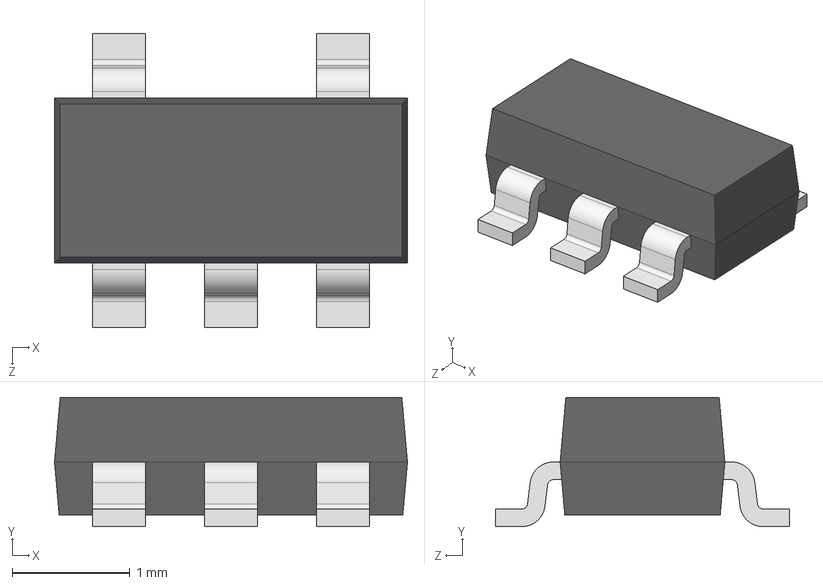
[picture p60: CAD file, 2017-01-18]
3D_Model/IC/SOT-23-5.step
3.00 x 1.10 x 2.50 mm
