NathanFSavoie/KiCad_lib/3D_Model/Resistors/R0805.step

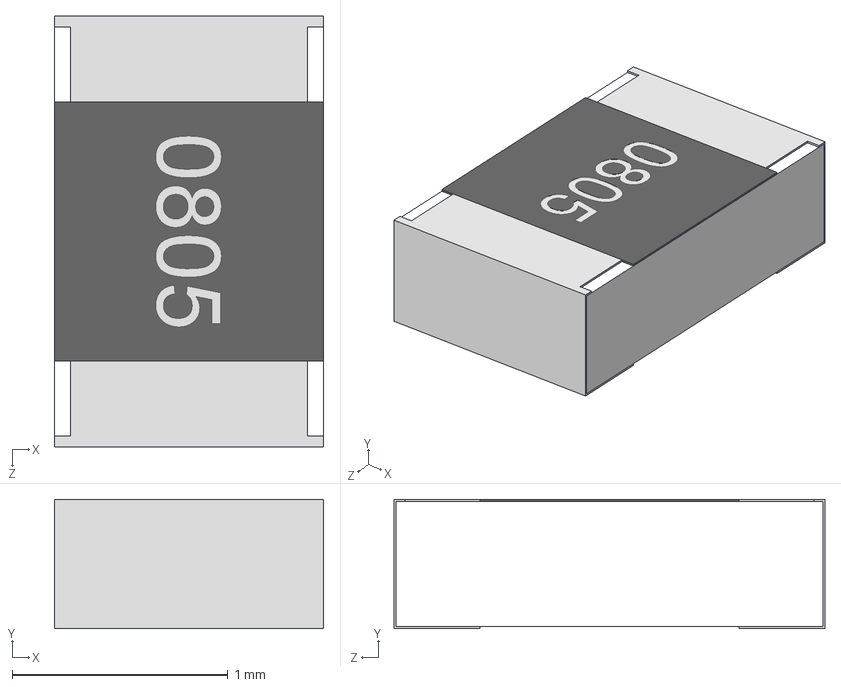
[picture p61: CAD file, 2017-04-19]
3D_Model/Resistors/R0805.step
1.25 x 0.6 x 2.00 mm
