NathanFSavoie/KiCad_lib/3D_Model/Connectors/female_header_2_54_2X19.stp

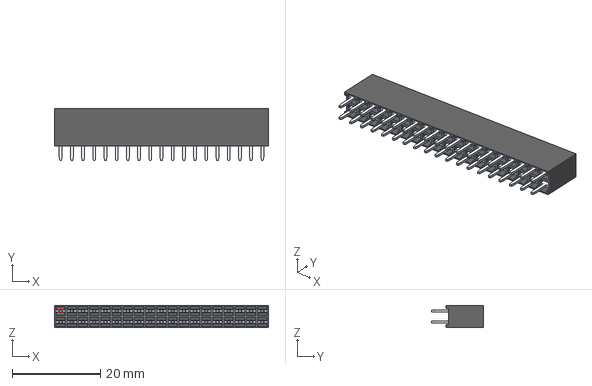
[picture p62: CAD file, 2017-02-01]
3D_Model/Connectors/female_header_2_54_2X19.stp
48.5 x 11.7 x 5.00 mm
