NathanFSavoie/KiCad_lib/3D_Model/IC/TO-263.step

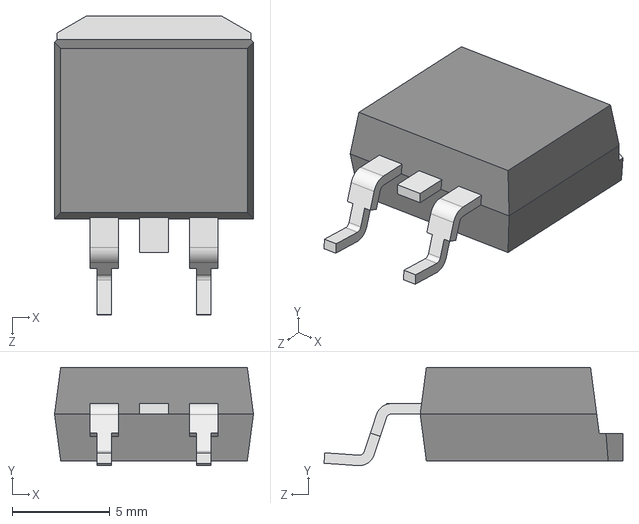
[picture p63: CAD file, 2017-01-18]
3D_Model/IC/TO-263.step
10.2 x 5.02 x 15.3 mm
