NathanFSavoie/KiCad_lib/3D_Model/Diodes/DO-214AC_SMA.step

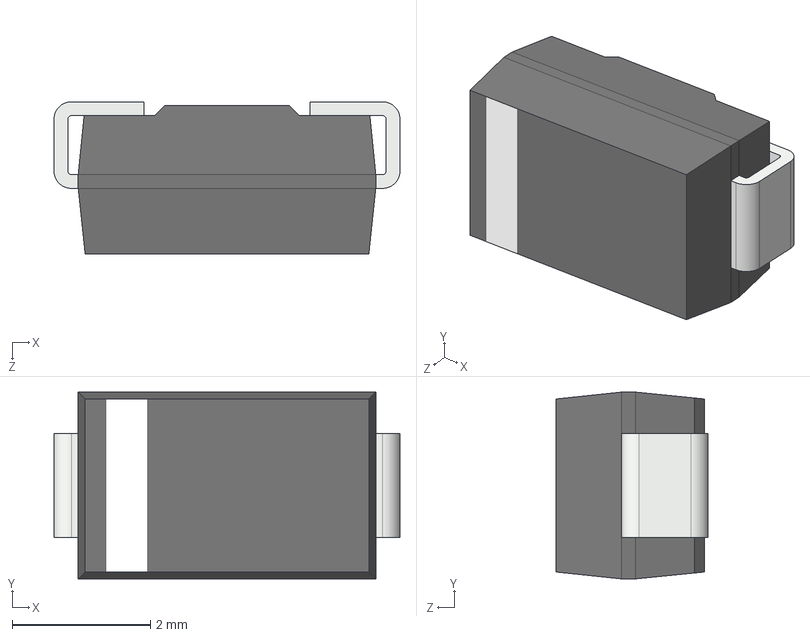
[picture p64: CAD file, 2017-01-22]
3D_Model/Diodes/DO-214AC_SMA.step
5.00 x 2.70 x 2.20 mm
