NathanFSavoie/KiCad_lib/3D_Model/IC/SSOP-24.step

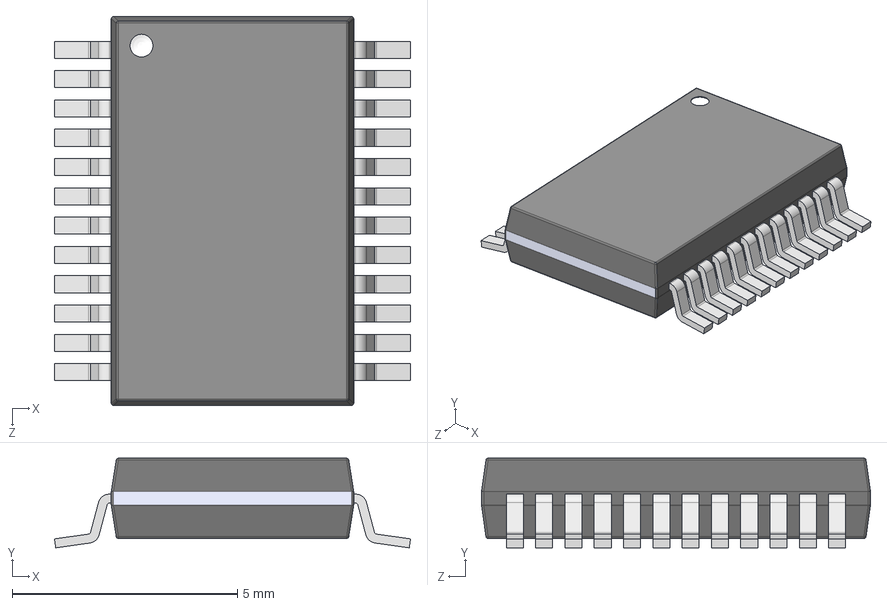
[picture p65: CAD file, 2017-01-18]
3D_Model/IC/SSOP-24.step
7.90 x 1.99 x 8.63 mm
