NathanFSavoie/KiCad_lib/3D_Model/Diodes/SOD-523.step

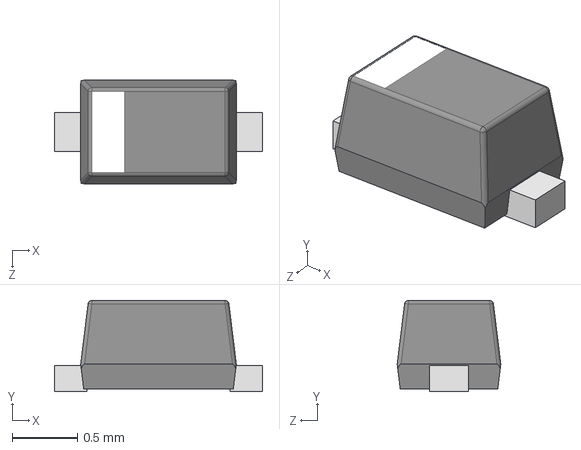
[picture p66: CAD file, 2017-01-22]
3D_Model/Diodes/SOD-523.step
1.60 x 0.7 x 0.798 mm
