NathanFSavoie/KiCad_lib/3D_Model/IC/MSOP-16.step

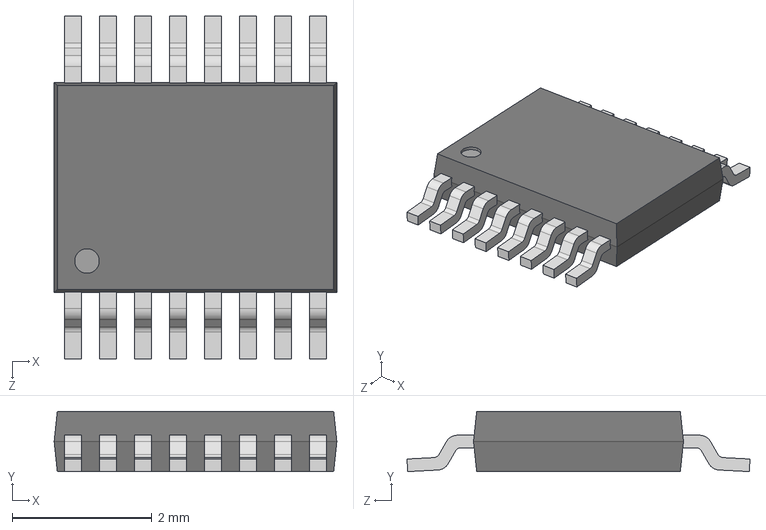
[picture p67: CAD file, 2017-01-18]
3D_Model/IC/MSOP-16.step
4.04 x 0.86 x 4.90 mm
