NathanFSavoie/KiCad_lib/3D_Model/Diodes/4-square.step

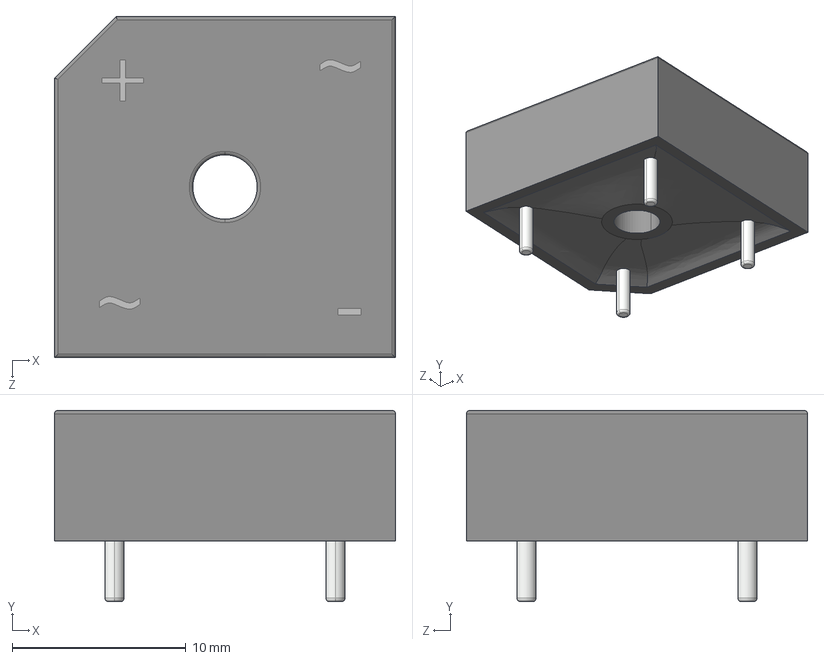
[picture p68: CAD file, 2017-01-22]
3D_Model/Diodes/4-square.step
19.6 x 11.0 x 19.6 mm
