NathanFSavoie/KiCad_lib/3D_Model/IC/MSOP-8.step

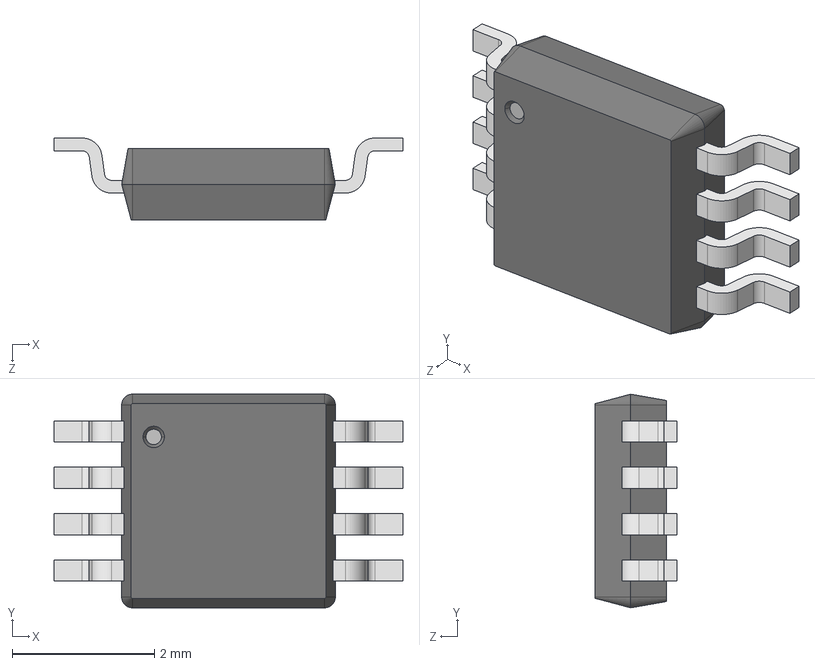
[picture p69: CAD file, 2017-01-18]
3D_Model/IC/MSOP-8.step
4.90 x 3.00 x 1.15 mm
