NathanFSavoie/KiCad_lib/3D_Model/Diodes/SOD-128.step

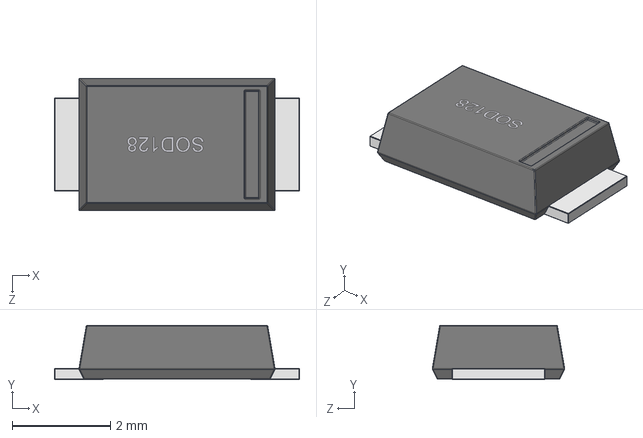
[picture p70: CAD file, 2017-01-22]
3D_Model/Diodes/SOD-128.step
5.00 x 1.11 x 2.70 mm
