NathanFSavoie/KiCad_lib/3D_Model/IC/SC70-4.step

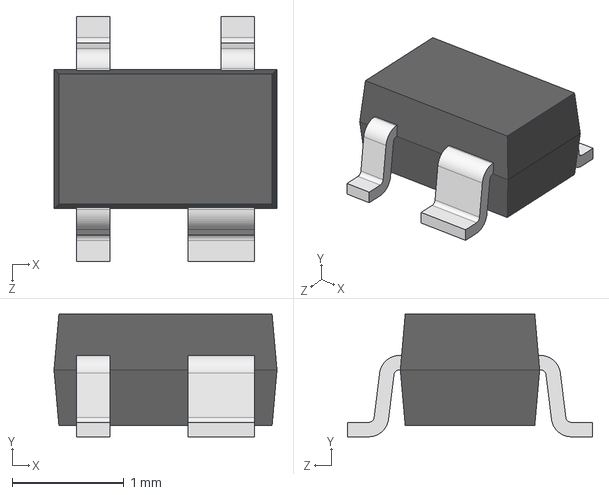
[picture p71: CAD file, 2017-01-18]
3D_Model/IC/SC70-4.step
2.00 x 1.10 x 2.20 mm
