NathanFSavoie/KiCad_lib/3D_Model/IC/SOT-23-3.step

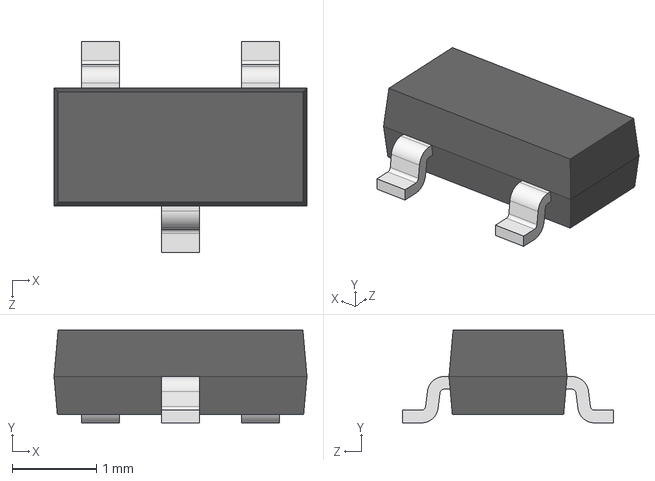
[picture p72: CAD file, 2017-01-18]
3D_Model/IC/SOT-23-3.step
3.00 x 1.10 x 2.50 mm
