NathanFSavoie/KiCad_lib/3D_Model/IC/TSSOP-14.step

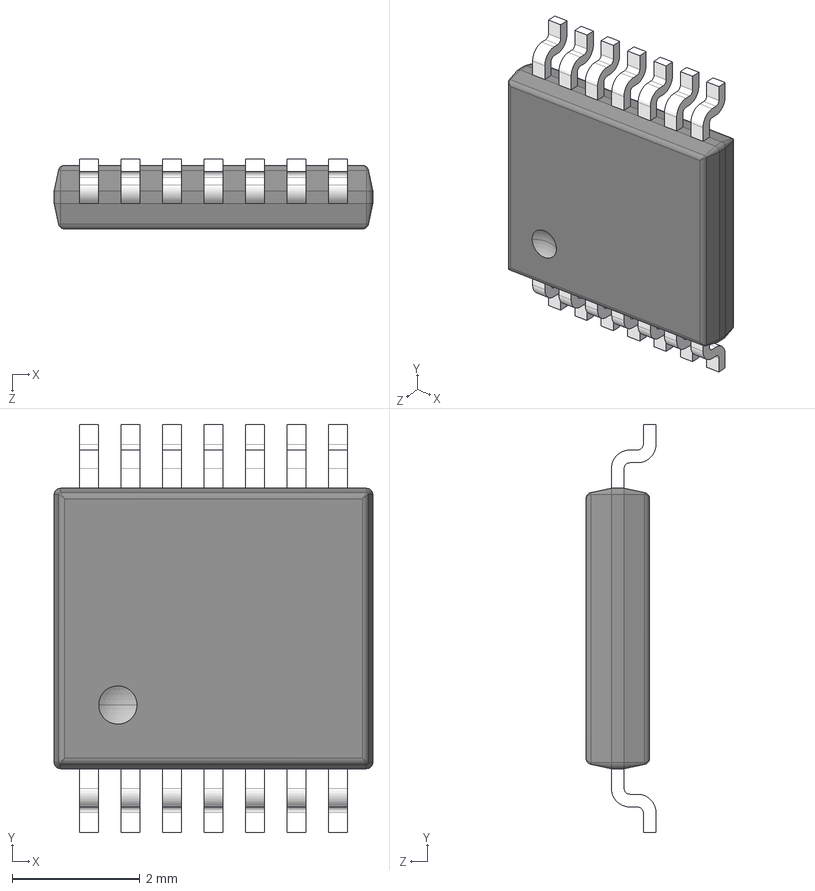
[picture p73: CAD file, 2017-01-18]
3D_Model/IC/TSSOP-14.step
5.00 x 6.40 x 1.10 mm
