NathanFSavoie/KiCad_lib/3D_Model/IC/TO-263-5.step

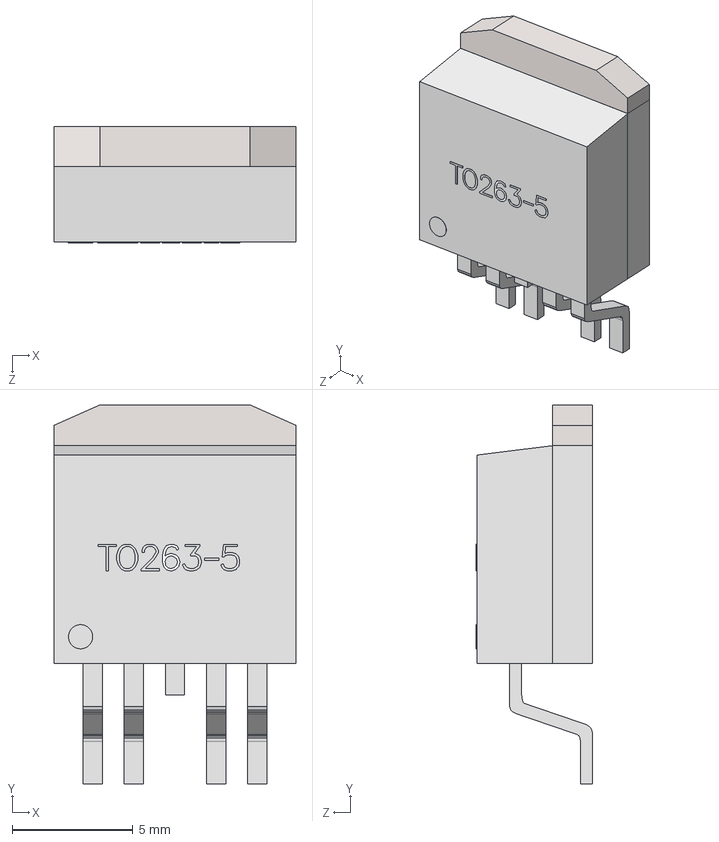
[picture p74: CAD file, 2017-01-18]
3D_Model/IC/TO-263-5.step
10.0 x 15.7 x 4.80 mm
SW3dPS-TO263-5S_Board7
SW3dPS-TO263-5S_Extruded20
SW3dPS-TO263-5S_Board8
SW3dPS-TO263-5S_Board5
SW3dPS-TO263-5S_Extruded13
SW3dPS-TO263-5S_Extruded23
SW3dPS-TO263-5S_Board6
SW3dPS-TO263-5S_Extruded19
SW3dPS-TO263-5S_Extruded12
SW3dPS-TO263-5S_Extruded17 x 4
SW3dPS-TO263-5S_Board9 x 4
SW3dPS-TO263-5S_Extruded22
SW3dPS-TO263-5S_Extruded14
SW3dPS-TO263-5S_Extruded21
SW3dPS-TO263-5S_Extruded15
SW3dPS-TO263-5S_Cylinder1
SW3dPS-TO263-5S_Extruded18
SW3dPS-TO263-5S_Extruded16
