NathanFSavoie/KiCad_lib/3D_Model/IC/SOT-89.step

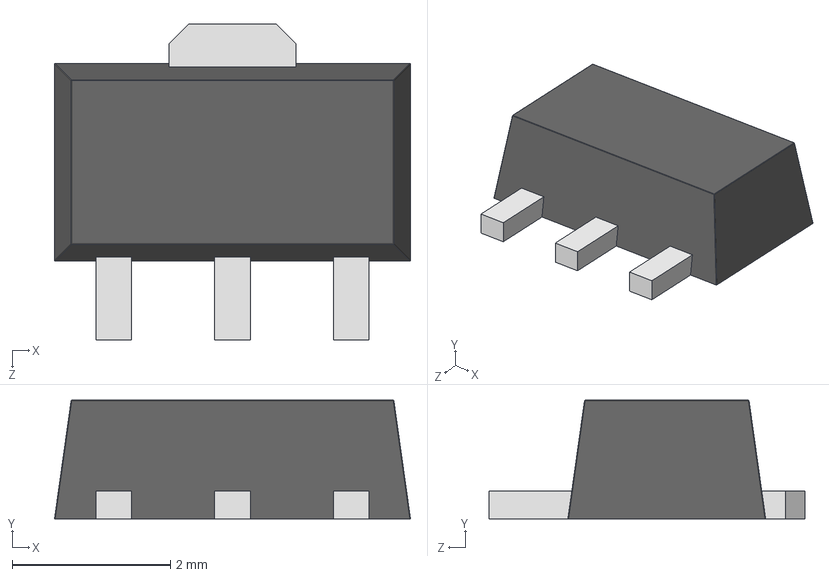
[picture p75: CAD file, 2017-01-18]
3D_Model/IC/SOT-89.step
4.50 x 1.50 x 4.00 mm
