NathanFSavoie/KiCad_lib/3D_Model/IC/TSOT-23-6.step

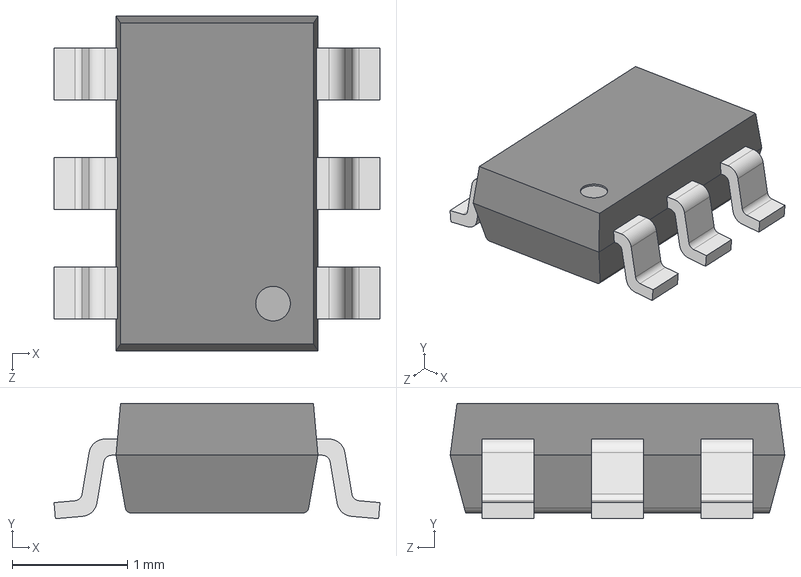
[picture p76: CAD file, 2017-01-18]
3D_Model/IC/TSOT-23-6.step
2.82 x 1.00 x 2.90 mm
