NathanFSavoie/KiCad_lib/3D_Model/IC/SOT-23-6.step

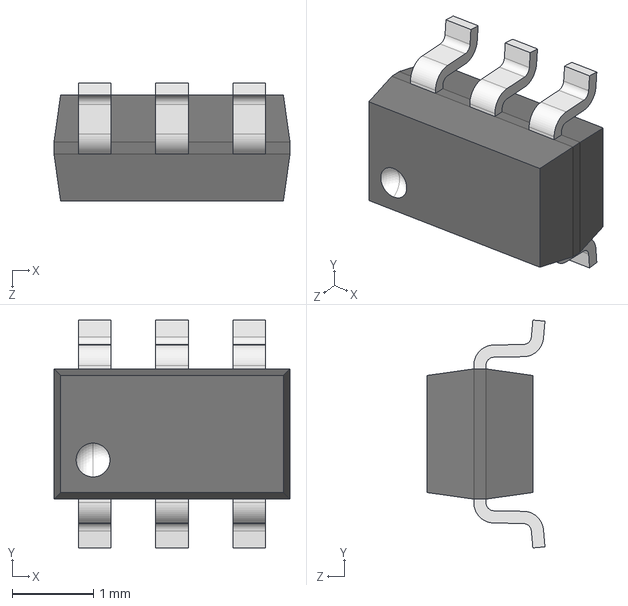
[picture p78: CAD file, 2017-01-18]
3D_Model/IC/SOT-23-6.step
2.90 x 2.80 x 1.45 mm
