NathanFSavoie/KiCad_lib/3D_Model/IC/SOIC-8_Wide_5mmx5mm.step

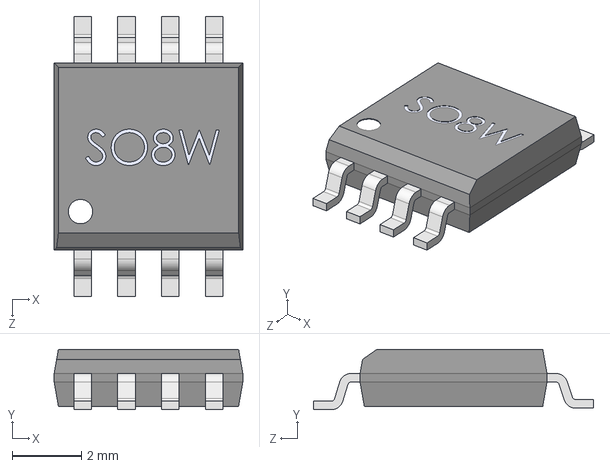
[picture p80: CAD file, 2017-01-18]
3D_Model/IC/SOIC-8_Wide_5mmx5mm.step
5.46 x 1.75 x 8.10 mm
