NathanFSavoie/KiCad_lib/3D_Model/IC/SOIC-14.step

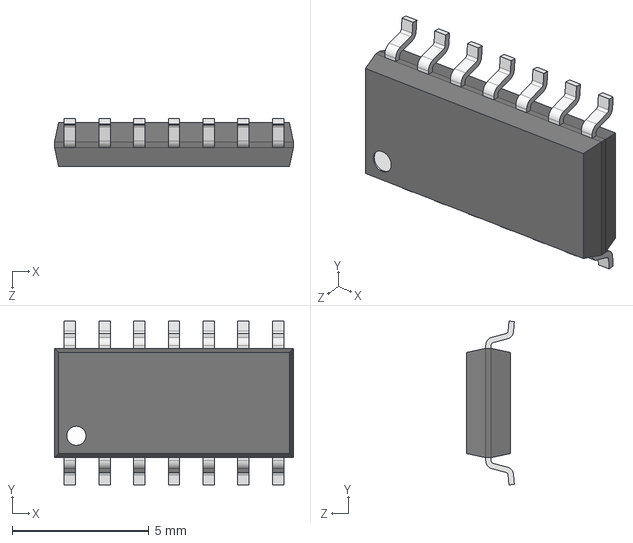
[picture p81: CAD file, 2017-01-18]
3D_Model/IC/SOIC-14.step
8.75 x 6.00 x 1.75 mm
