NathanFSavoie/KiCad_lib/3D_Model/IC/MSOP-12.step

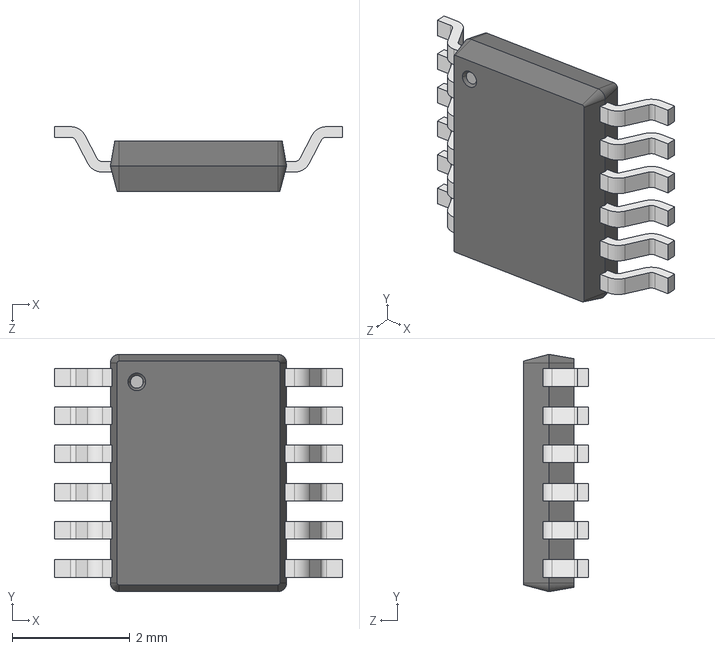
[picture p82: CAD file, 2017-01-18]
3D_Model/IC/MSOP-12.step
4.90 x 4.04 x 1.10 mm
