NathanFSavoie/KiCad_lib/3D_Model/IC/SOT-223.step

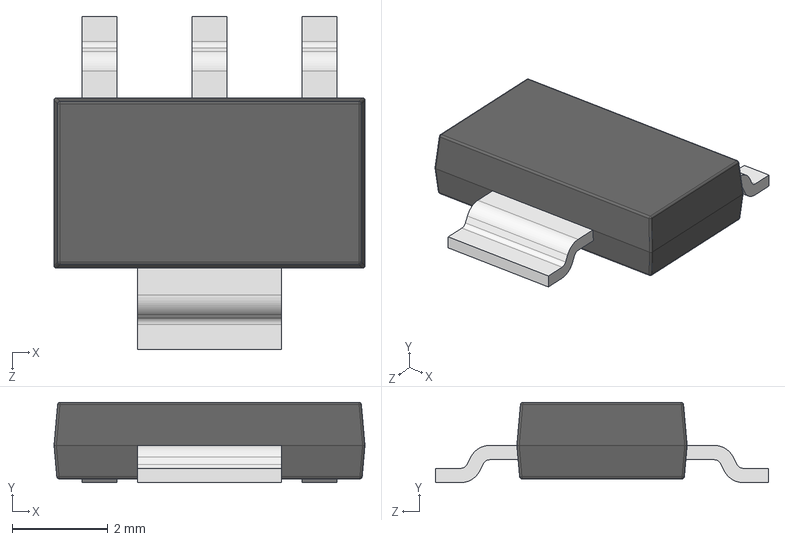
[picture p83: CAD file, 2017-01-18]
3D_Model/IC/SOT-223.step
6.50 x 1.68 x 6.96 mm
