NathanFSavoie/KiCad_lib/3D_Model/IC/TO-220-7.step

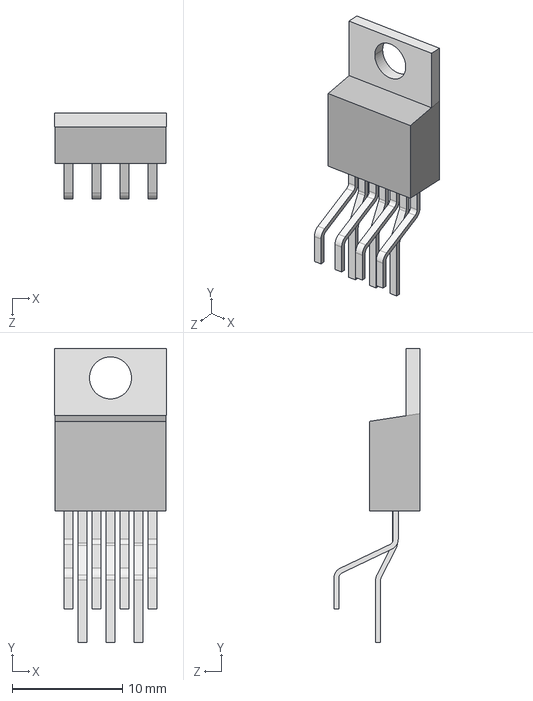
[picture p84: CAD file, 2017-01-18]
3D_Model/IC/TO-220-7.step
10.2 x 26.7 x 7.82 mm
