NathanFSavoie/KiCad_lib/3D_Model/IC/MSOP-10.step

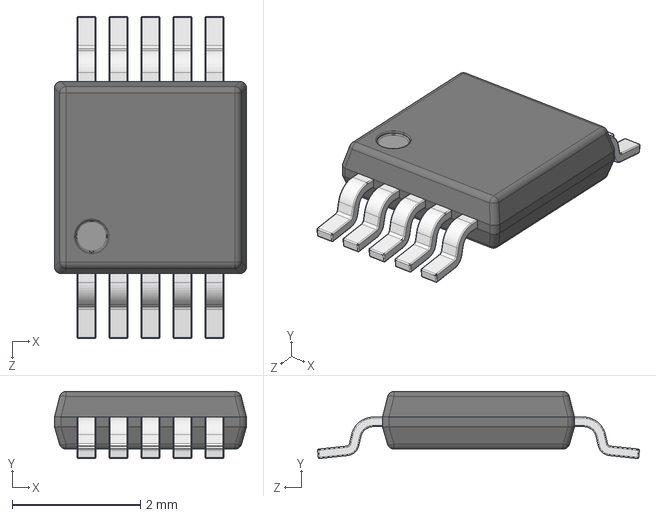
[picture p85: CAD file, 2017-01-18]
3D_Model/IC/MSOP-10.step
3.00 x 1.05 x 5.03 mm
