NathanFSavoie/KiCad_lib/3D_Model/IC/TSSOP-16.step

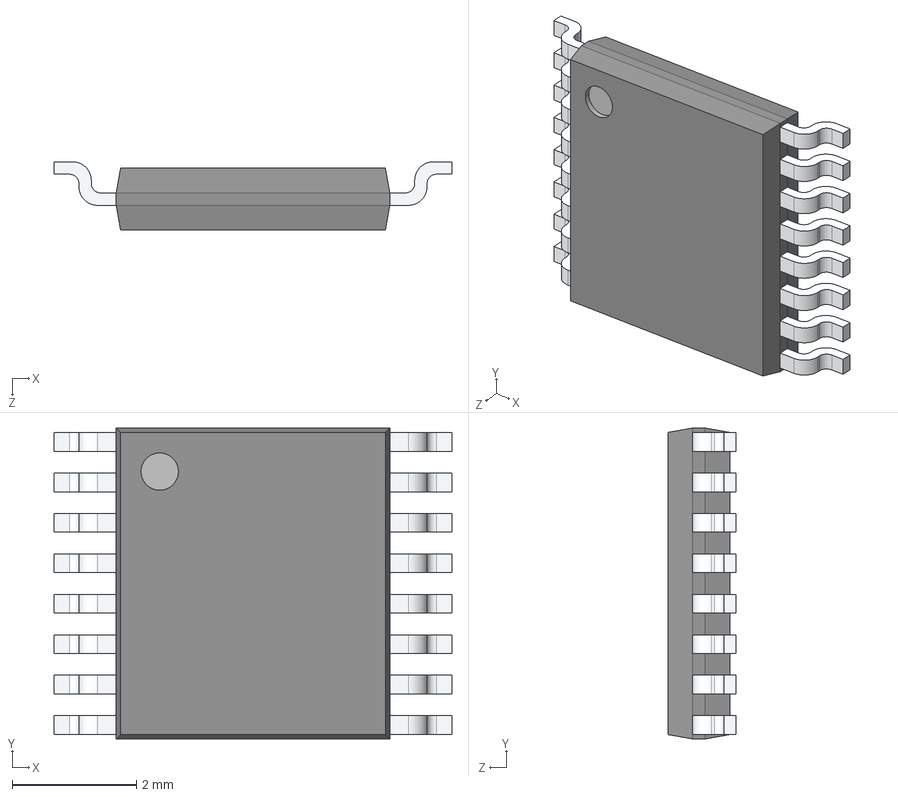
[picture p86: CAD file, 2017-01-18]
3D_Model/IC/TSSOP-16.step
6.40 x 5.00 x 1.10 mm
