NathanFSavoie/KiCad_lib/3D_Model/IC/SSOP-20.step

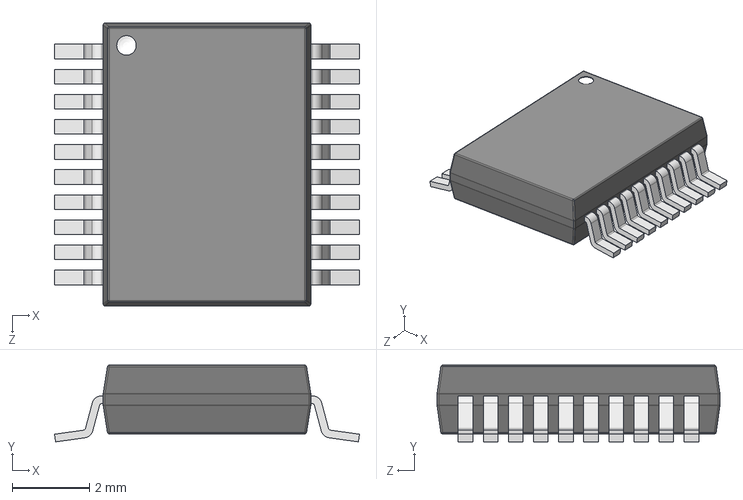
[picture p87: CAD file, 2017-01-18]
3D_Model/IC/SSOP-20.step
7.90 x 1.99 x 7.33 mm
