NathanFSavoie/KiCad_lib/3D_Model/IC/TO-220.step

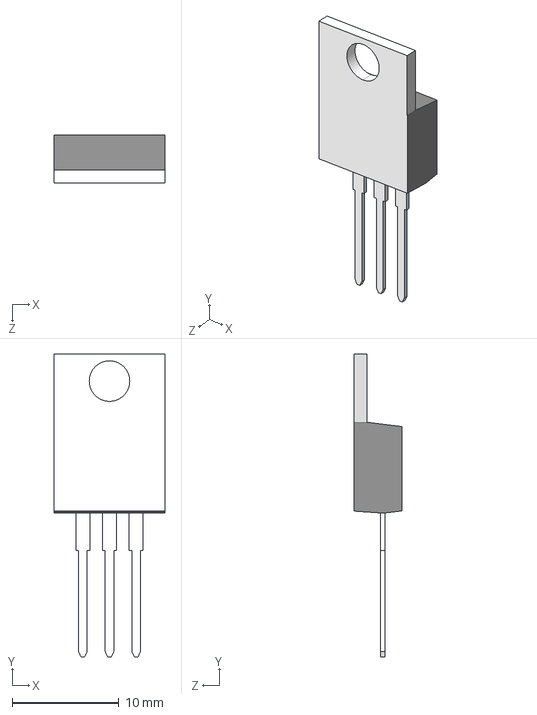
[picture p88: CAD file, 2017-01-18]
3D_Model/IC/TO-220.step
10.4 x 28.4 x 4.50 mm
