NathanFSavoie/KiCad_lib/(list of files, cad)

Other CAD files:
3D_Model/Resistors/R1206.step
3D_Model/Capacitors/C1206.step
3D_Model/IC/TO-263-3.step
3D_Model/Connectors/1694224.stp
3D_Model/Connectors/1694240.stp
3D_Model/Connectors/1935161.step
3D_Model/Connectors/1935161.stp
3D_Model/Connectors/1935174.stp
3D_Model/Connectors/1935187.stp
