NathanFSavoie/KiCad_lib/(commit log)

2017-01-22 Add 3D to resistor
2017-01-22 add 3D model to diode
    [4-sip_KBU.step, 4-square.step, DO-214AA_SMB.step, DO-214AC_SMA.step, R-6.step, SOD-123FL.step, SOD-128.step, SOD-523.step]
2017-01-22 add MSOP-8-EP footprint
2017-01-22 add SRR1208-470YL
    [SRR1208.step]
2017-01-22 add SRR4018 and 4028
    [SRR4018.stp, SRR4028.stp]
2017-01-25 rename Circuit_integre to circuit integre
2017-01-31 add terminal block
    [1935161.stp]
2017-01-31 add pin number terminal block
2017-01-31 working on tact switch
    [PTS645S.step, Tactile_switch_6x6x5mm.step]
2017-02-01 update switches footprint
    [female_header_2_54_2X19.stp]
2017-02-01 add switches schematic
2017-02-02 create footprint Female Header 2X19
2017-02-15 fixing error of space in circuit integre
2017-03-17 Add relay folder and add VBat in power port
2017-04-19 add 3D model Cap
    [SMD_Radial_Can_10_0x12_6.STEP, SMD_Radial_Can_10x10x10-1.STEP, SMD_Radial_Can_4_0x5_4.STEP, SMD_Radial_Can_5_0x5_9.STEP, SMD_Radial_Can_5x5_4.step, SMD_Radial_Can_6_3x5_9.STEP, SMD_Radial_Can_8_0x11_9.STEP, SMD_Radial_Can_8_0x6_9.STEP]
2017-04-19 add capacitors
2017-04-19 add oki-78 regulator
    [mps_dcdc_oki_78sr_horiz_a.step, mps_dcdc_oki_78sr_vert_a.step]
2017-04-29 copy lib eclipse + add inductors footprint
    [1694224.stp, 1694240.stp, Littelfuse_562.stp, Littelfuse_TE5_395.step, SMD_Radial_Can_10_0x12_6.STEP, SMD_Radial_Can_10x10x10-1.STEP, SMD_Radial_Can_4_0x5_4.STEP, SMD_Radial_Can_5_0x5_9.STEP]
2017-04-30 add 3D Sot-363
    [SOT-363.step]
2017-05-02 add STM32F051
2017-05-03 add potentiometer series CT6EP
    [CT-6EP.stp]
2017-05-03 add term block 1935161
    [1935161.stp]
2017-05-03 add TERM BLOCK 1935174
    [1935174.stp]
2017-05-03 add TERM BLOCK 1935187
    [1935187.stp]
2017-05-03 add LQFP-32
    [LQFP-32.step]
2017-05-03 add 10k resistor
2017-05-06 minor fix on resistor symbol
2017-05-06 reverse pin position (1 to left)
2017-05-06 add footprint MF52 (NTC)
2017-05-06 add TVS 12V
2017-05-08 add multiple value of resistors
2017-05-08 add current sense resistor
2017-05-09 add Resistors
2017-05-09 add RLB0608 inductor
    [RLB0608.step]
2017-05-10 add 2 and 2.5A Fuses
2017-05-10 add P-CH fet
2017-05-10 add holder name in footprint name
2017-05-10 add UVZ1A471MED
    [UVZ_6_3×11.stp]
2017-05-11 add SOD-323 footprint + NSR0530HT1G
    [SOD-323.step]
2017-05-11 add LBC inductor
    [LBC3225.stp]
2017-05-23 Add connector
2017-07-03 Change LED 5630
2017-07-13 LED Driver Add EEPROM
2017-10-21 Projet LED_DRIVER terminé
    [1935161.step, Bourns 3362R_sp.step, C1206.step, CAP_ALU_SMD_SIZE_B.step, CAP_ALU_SMD_SIZE_C.step, CAP_ALU_SMD_SIZE_D.step, CTDEFAU05151246231556_sp.step, Crystal HC49_US-SM.step]
2017-11-20 Motor Driver
    [SOD-123.step]
2018-08-07 Finit le schemas driver moteur single
